Liam-McCord/PNP-Project-ENMT211/printing comparison.png

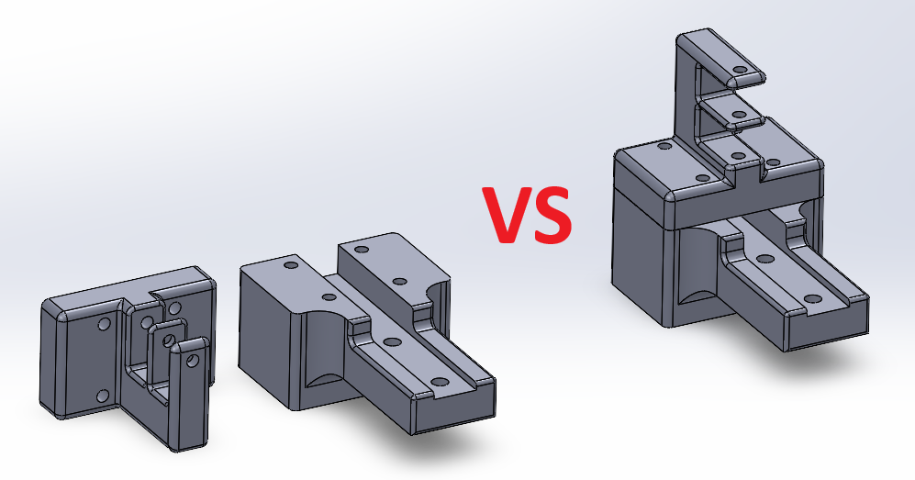
printing comparison.png
