Liam-McCord/PNP-Project-ENMT211/Report+ProjectPlanning/SketchesOfDesignIdeas/20240717_143712.jpg

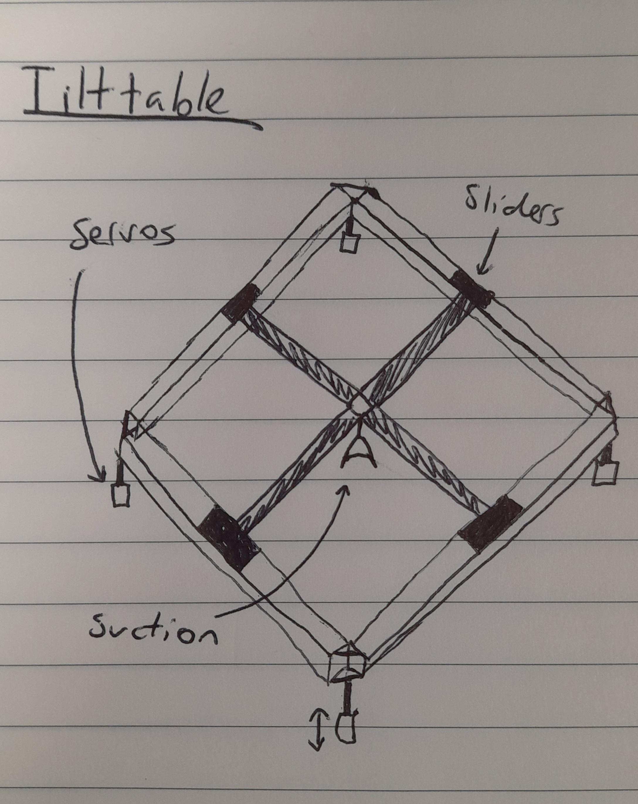
Report+ProjectPlanning/SketchesOfDesignIdeas/20240717_143712.jpg
