Liam-McCord/PNP-Project-ENMT211/MeetingNotes/19.07-meetingtopics.md

# Topics for discussion 19.07.2024

## Design Ideas

- Re-orientate bearing slides to upmost edges
- Discuss lead-screw rather than belt drive
- Discuss material selection

## Administration

- Decide on next meeting time/place
- Decide on time-line for project
- Decide when/if we are doing presentation

## Outcomes (hopefully!)

- Finalise (somewhat) initial design
- Ensure everyone is on same page/understanding
- Ensure everyone is happy with current progress/state of project
