Liam-McCord/PNP-Project-ENMT211/Report+ProjectPlanning/SketchesOfDesignIdeas/PhilipGantryDesign1.pdf

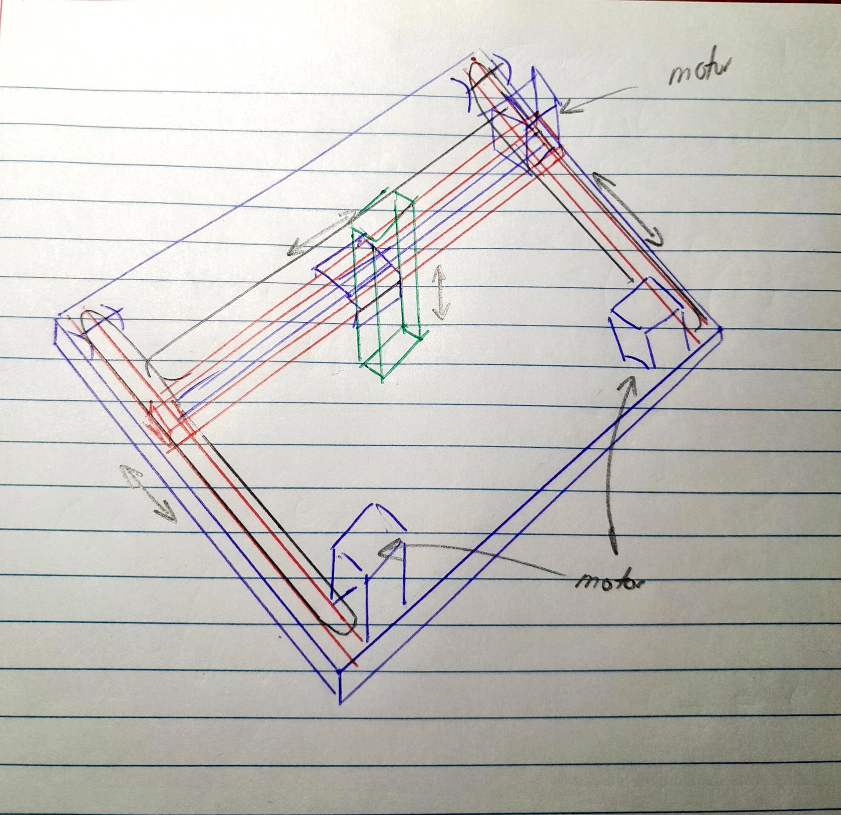
[picture p3: page 1]
