Liam-McCord/PNP-Project-ENMT211/Lab 01 Group 16 group submission/Overall Individual Contributions.pdf

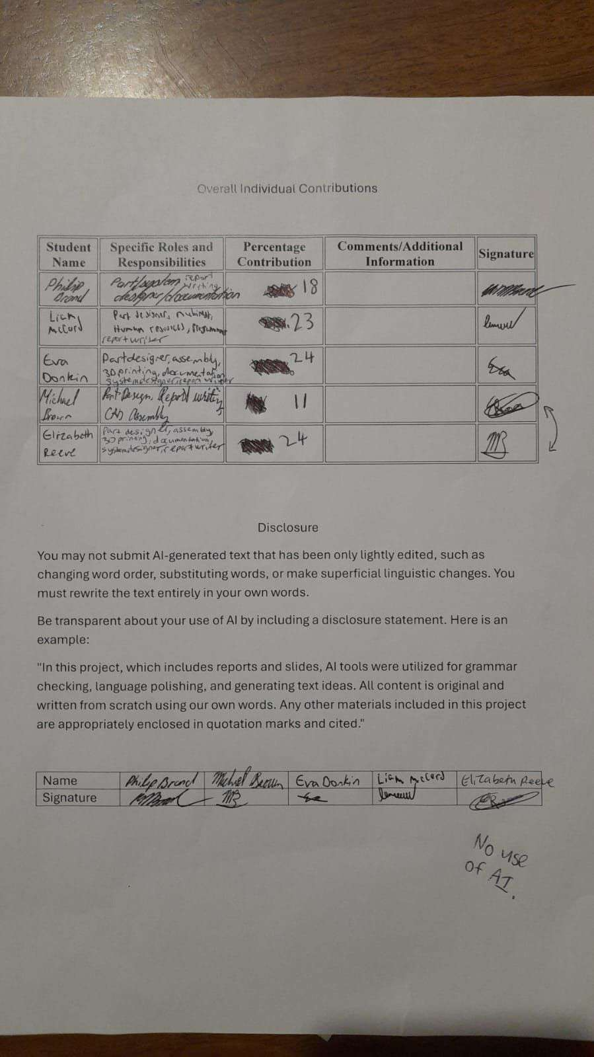
[picture p4: page 1]
