Liam-McCord/PNP-Project-ENMT211/bracket comparsion.png

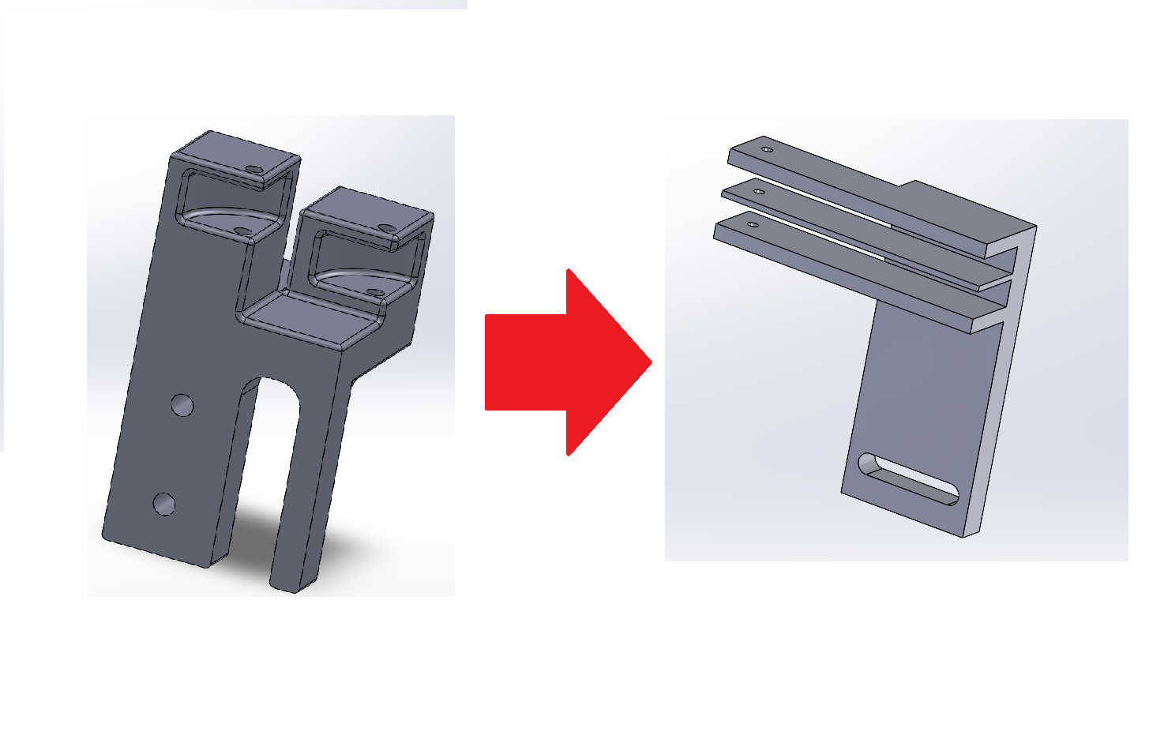
bracket comparsion.png
