Liam-McCord/PNP-Project-ENMT211/PNP.jpg

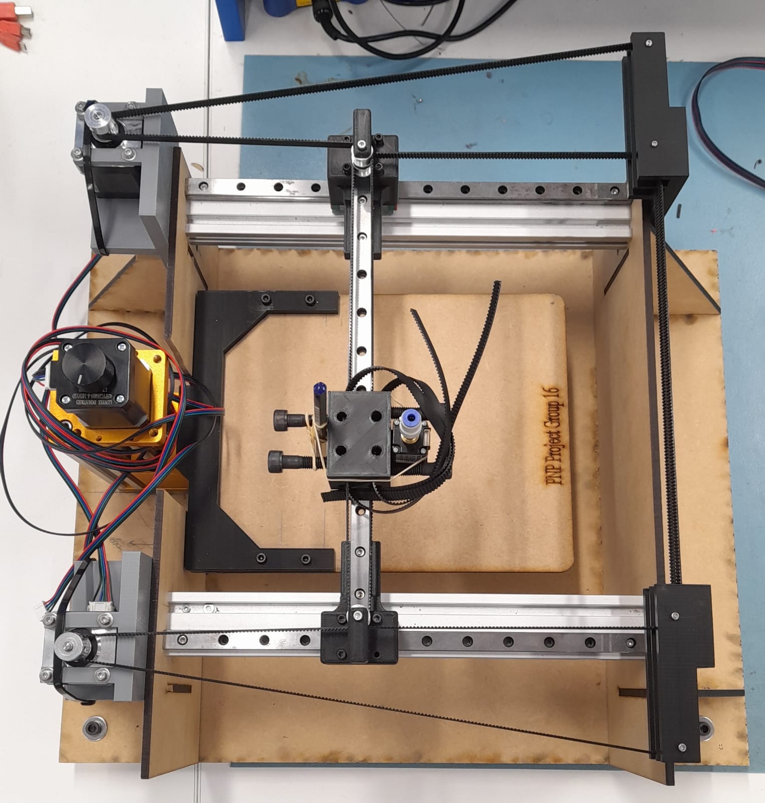
PNP.jpg
