Liam-McCord/PNP-Project-ENMT211/Report+ProjectPlanning/SketchesOfDesignIdeas/design3.png

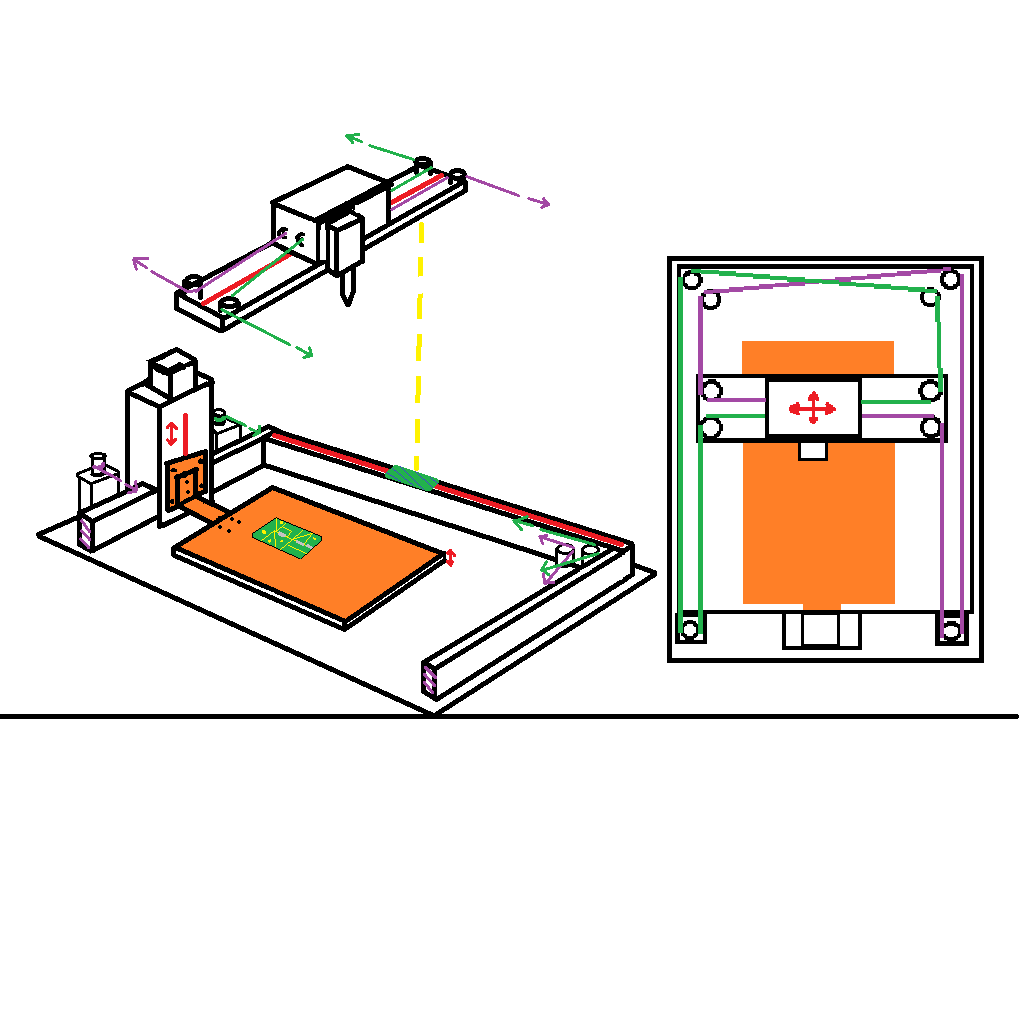
Report+ProjectPlanning/SketchesOfDesignIdeas/design3.png
