Liam-McCord/PNP-Project-ENMT211/Report+ProjectPlanning/SketchesOfDesignIdeas/IMG_0171.jpg

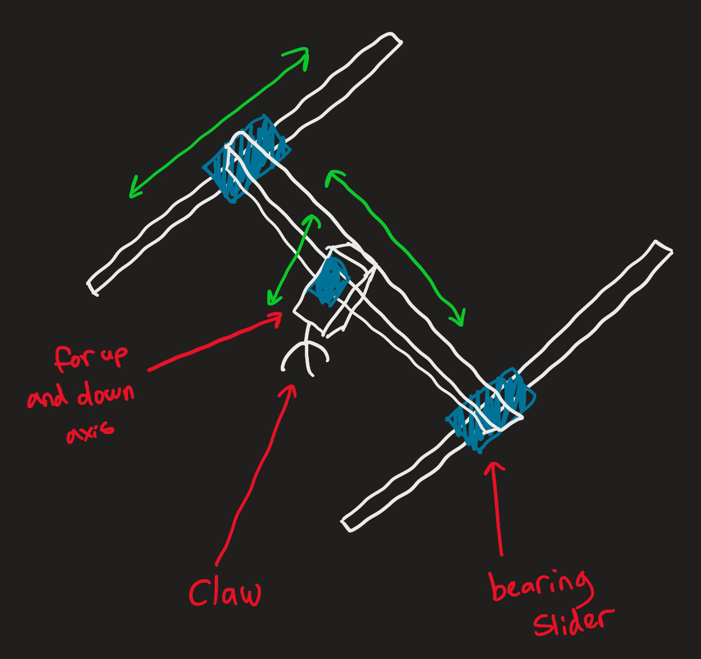
Report+ProjectPlanning/SketchesOfDesignIdeas/IMG_0171.jpg
