Liam-McCord/PNP-Project-ENMT211/Report+ProjectPlanning/SketchesOfDesignIdeas/IMG_0172.jpg

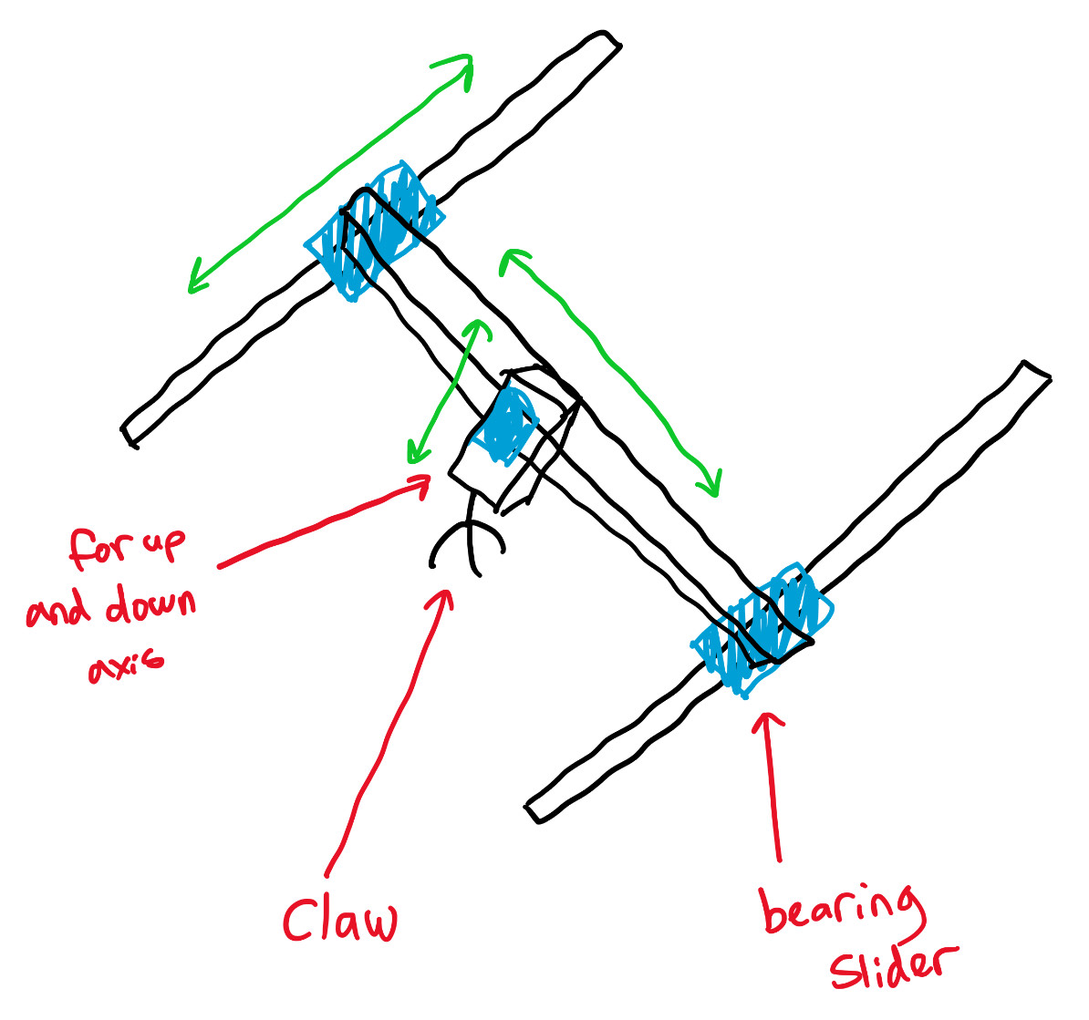
Report+ProjectPlanning/SketchesOfDesignIdeas/IMG_0172.jpg
