Liam-McCord/PNP-Project-ENMT211/Report+ProjectPlanning/SketchesOfDesignIdeas/LiamGantryDesign1.jpg

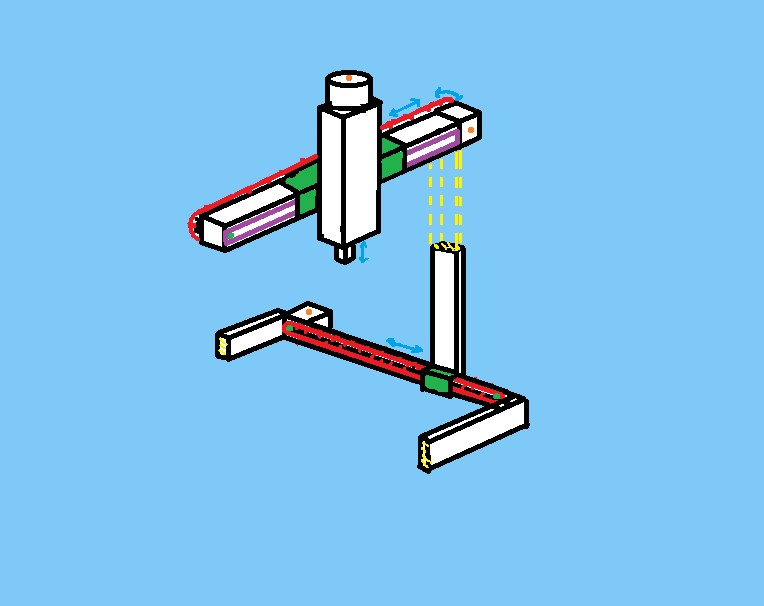
Report+ProjectPlanning/SketchesOfDesignIdeas/LiamGantryDesign1.jpg
