Liam-McCord/PNP-Project-ENMT211/Report+ProjectPlanning/SketchesOfDesignIdeas/Michael - Moving platform design.jpg

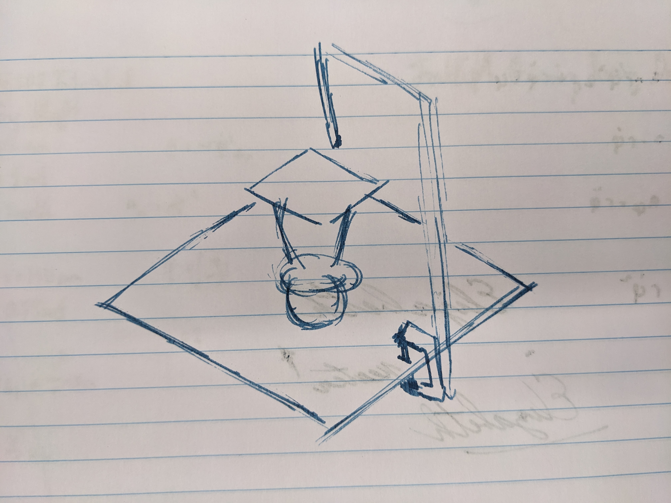
Report+ProjectPlanning/SketchesOfDesignIdeas/Michael - Moving platform design.jpg
