Liam-McCord/PNP-Project-ENMT211/Report+ProjectPlanning/SketchesOfDesignIdeas/PNPdesignupdated.png

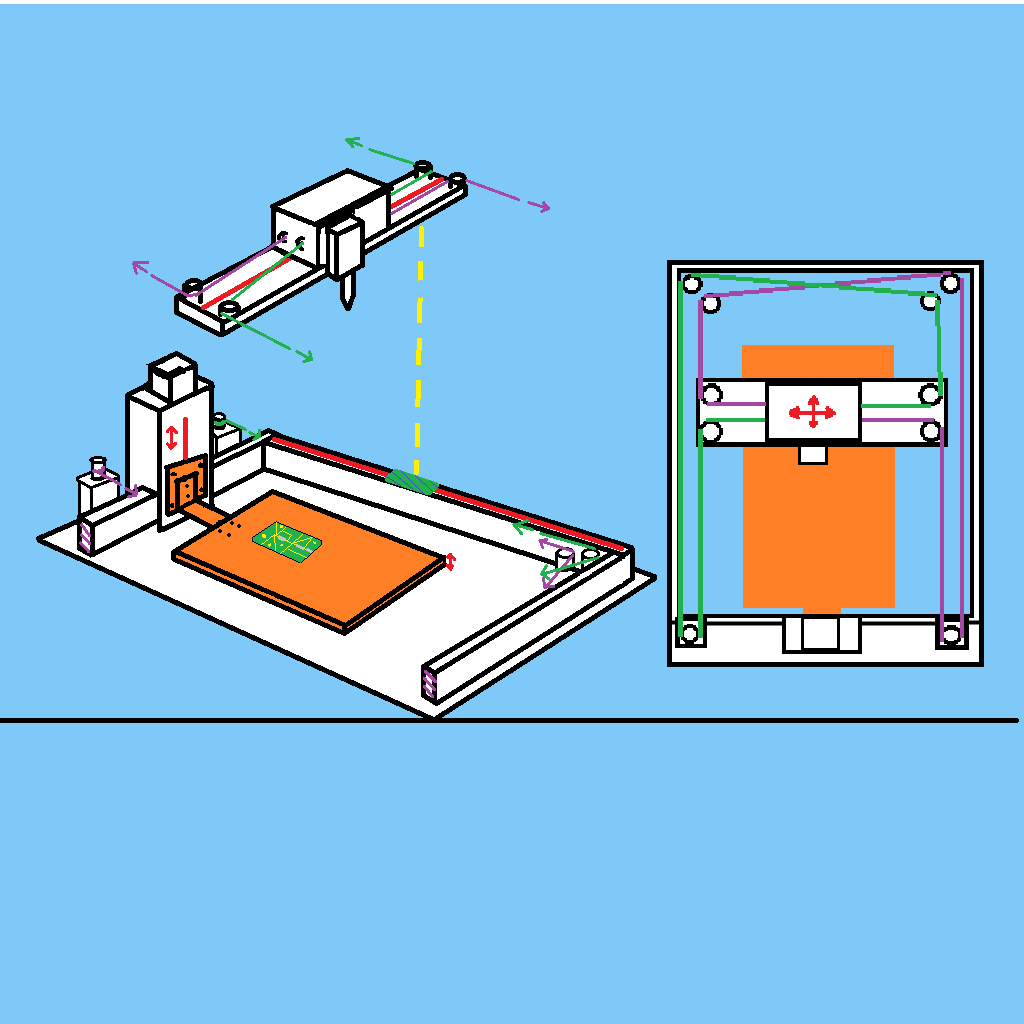
Report+ProjectPlanning/SketchesOfDesignIdeas/PNPdesignupdated.png
