Liam-McCord/PNP-Project-ENMT211/Assembly Files/Assemblies/01 - Board Assembly.SLDASM

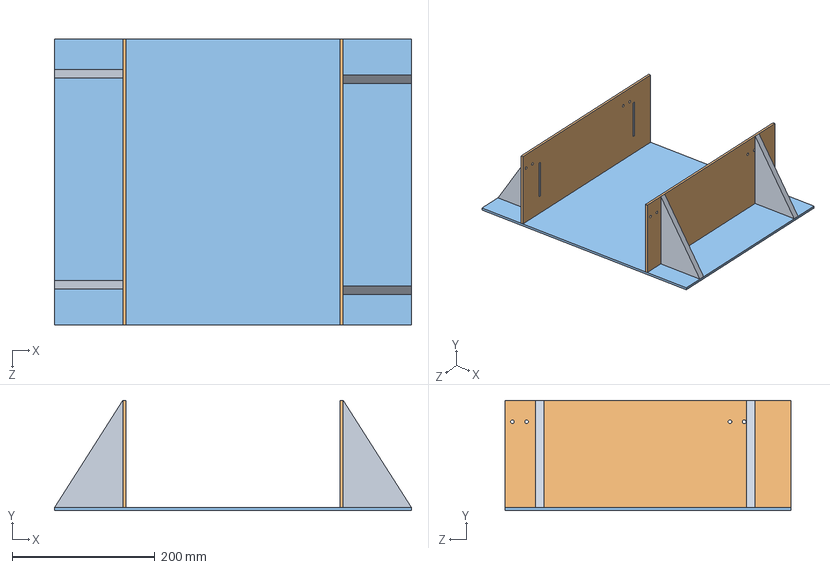
[picture p13: CAD file, 2024-08-05]
Assembly Files/Assemblies/01 - Board Assembly.SLDASM
500.0 x 154.5 x 400.1 mm
Bottom Plate
Side Walls x 2
Gussets x 4
