Liam-McCord/PNP-Project-ENMT211/Assembly Files/Assemblies/02 - Board with 2 Beams Assembly.SLDASM

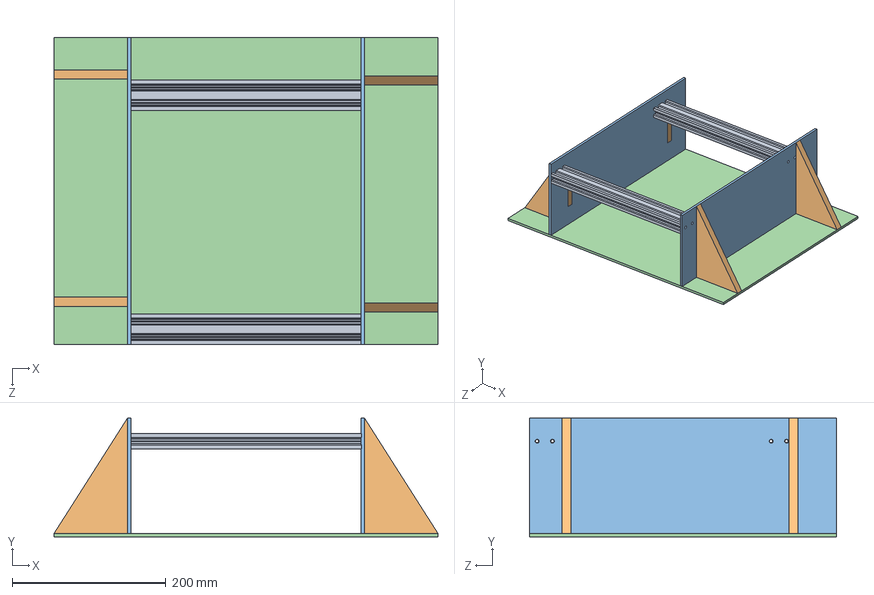
[picture p14: CAD file, 2024-08-05]
Assembly Files/Assemblies/02 - Board with 2 Beams Assembly.SLDASM
500.0 x 154.5 x 400.1 mm
Bottom Plate
Side Walls x 2
Gussets x 4
2040 Aluminim profile x 2
