Liam-McCord/PNP-Project-ENMT211/Assembly Files/Individual Parts/Slider Block/MGN12H.SLDASM

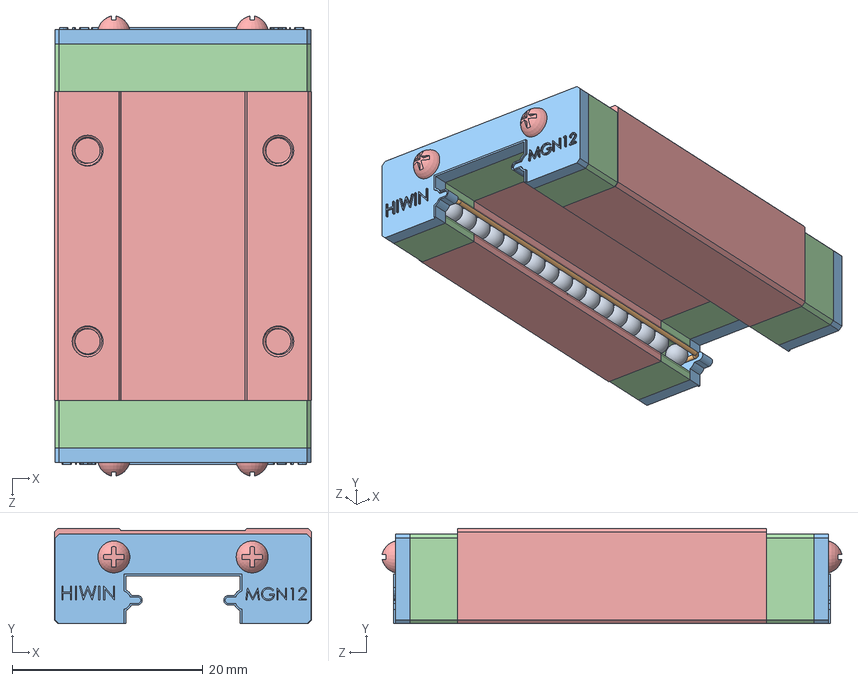
[picture p15: CAD file, 2024-08-05]
Assembly Files/Individual Parts/Slider Block/MGN12H.SLDASM
27.0 x 10.0 x 48.2 mm
MGN12H_Body
MGN12H_EndCap x 2
MGN12H_Seal x 2
MGN12H_Cage x 2
MGN12H_Ball x 34
