Liam-McCord/PNP-Project-ENMT211/Assembly Files/Assemblies/04 - Assembly with Motors.SLDASM

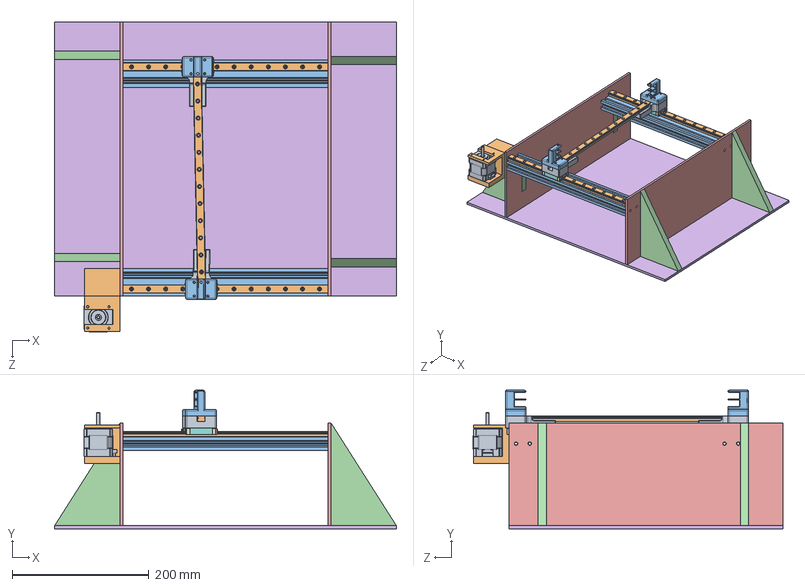
[picture p16: CAD file, 2024-08-05]
Assembly Files/Assemblies/04 - Assembly with Motors.SLDASM
500.0 x 202.5 x 452.8 mm
Bottom Plate
Side Walls x 2
Gussets x 4
2040 Aluminim profile x 2
Modified Beam 30CM x 3
Slider Attachment Bottom x 2
MGN12H_Body x 2
MGN12H_EndCap x 4
MGN12H_Seal x 4
MGN12H_Cage x 4
MGN12H_Ball x 68
Slider Attachment Top x 2
Motor Mount Long Side 1
DC Stepper Motor
