Liam-McCord/PNP-Project-ENMT211/Assembly Files/Individual Parts/Side Walls.SLDPRT

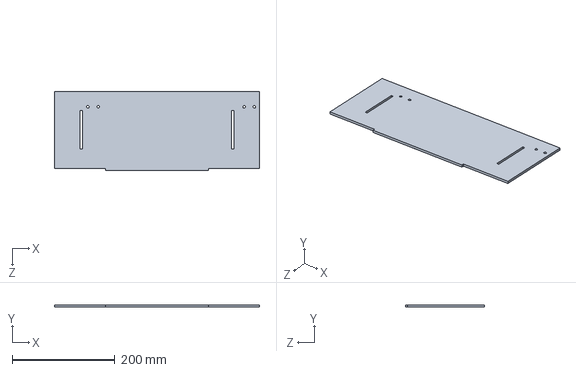
[picture p17: CAD file, 2024-08-05]
Assembly Files/Individual Parts/Side Walls.SLDPRT
400.0 x 4.50 x 154.5 mm
