Liam-McCord/PNP-Project-ENMT211/Assembly Files/Individual Parts/Slider Block/MGN12H_Seal.SLDPRT

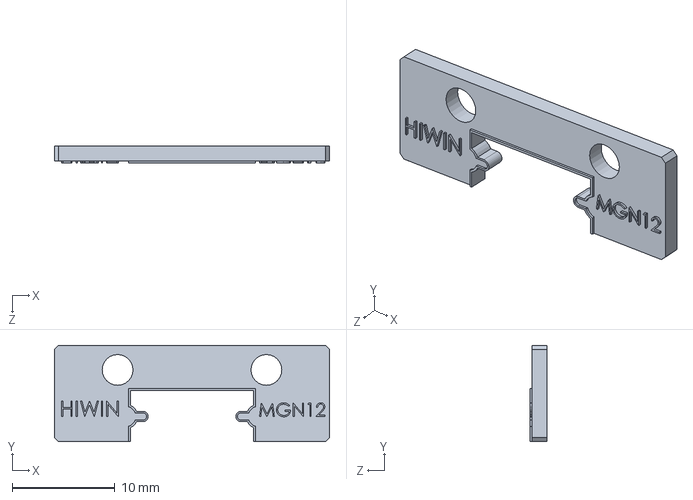
[picture p18: CAD file, 2024-08-05]
Assembly Files/Individual Parts/Slider Block/MGN12H_Seal.SLDPRT
26.8 x 9.40 x 1.70 mm
