Liam-McCord/PNP-Project-ENMT211/Lab 01 Group 16 group submission/CAD files/FDM/pulley support.SLDPRT

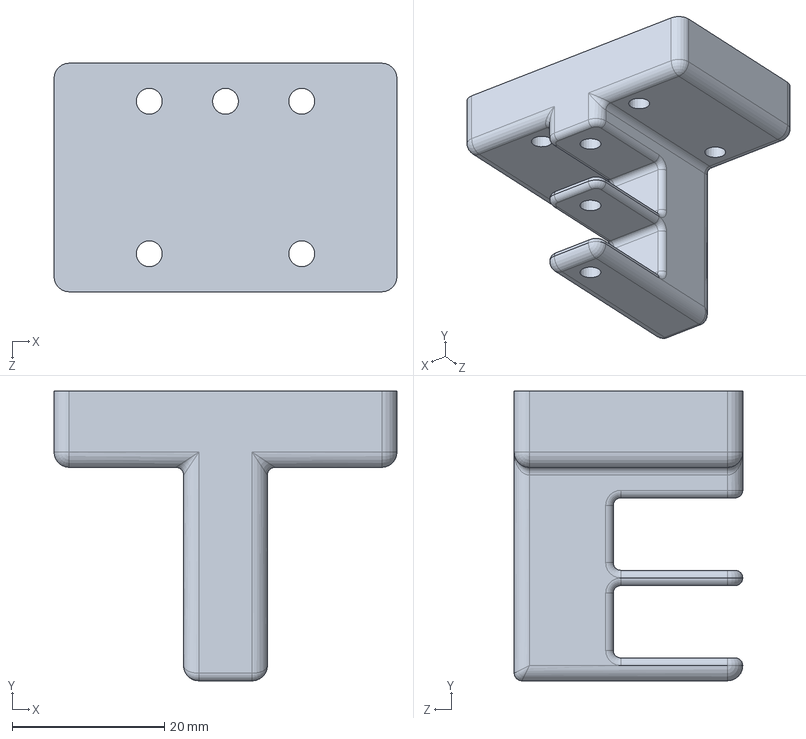
[picture p19: CAD file, 2024-08-16]
Lab 01 Group 16 group submission/CAD files/FDM/pulley support.SLDPRT
45.0 x 38.0 x 30.0 mm
