Liam-McCord/PNP-Project-ENMT211/Lab 01 Group 16 group submission/CAD files/lasercutting/baseplate-plate-to-lasercut.SLDPRT

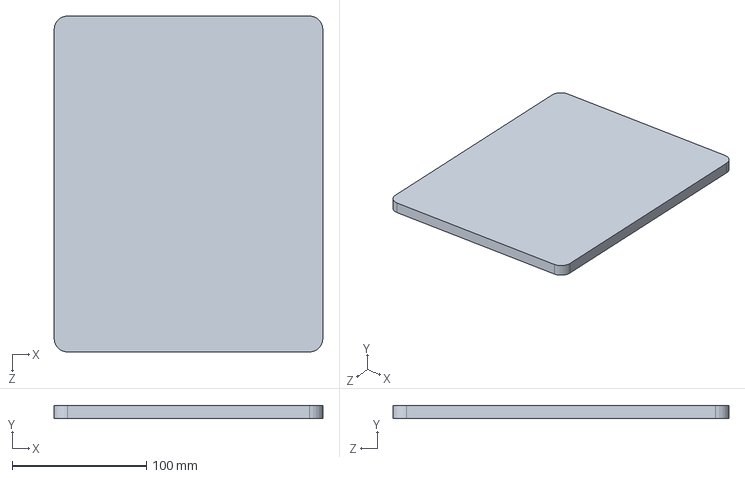
[picture p20: CAD file, 2024-08-06]
Lab 01 Group 16 group submission/CAD files/lasercutting/baseplate-plate-to-lasercut.SLDPRT
200.0 x 10.0 x 250.0 mm
