Liam-McCord/PNP-Project-ENMT211/Mounts&Brackets for Printing/bracket connecting perpendicular glides/rail mount/part1-final.STL

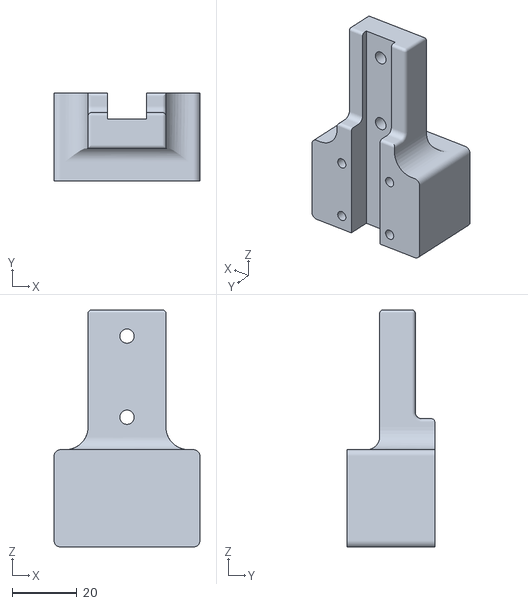
[picture p21: CAD file, 2024-08-06]
Mounts&Brackets for Printing/bracket connecting perpendicular glides/rail mount/part1-final.STL
45.0 x 27.0 x 73.1
