Liam-McCord/PNP-Project-ENMT211/Mounts&Brackets for Printing/motor mount/Motor Mount.STL

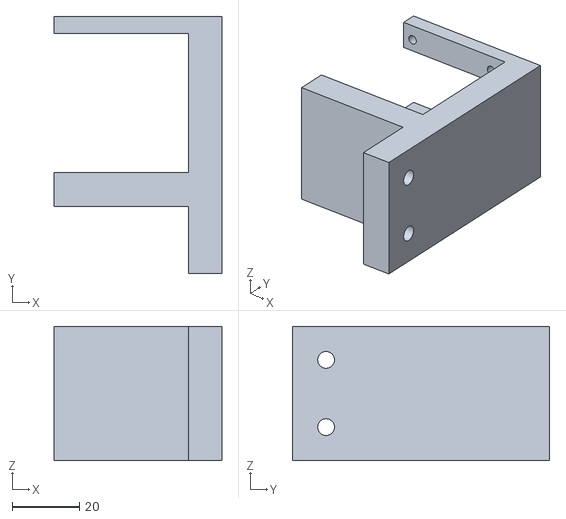
[picture p22: CAD file, 2024-08-05]
Mounts&Brackets for Printing/motor mount/Motor Mount.STL
50.0 x 76.5 x 40.0
