Liam-McCord/PNP-Project-ENMT211/Mounts&Brackets for Printing/Moving Platform Mount.STL

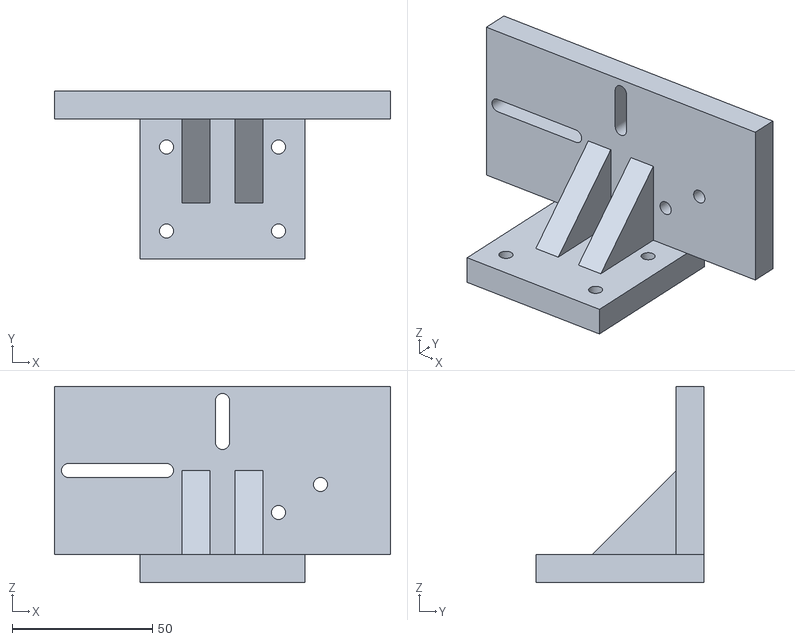
[picture p23: CAD file, 2024-07-30]
Mounts&Brackets for Printing/Moving Platform Mount.STL
120.0 x 60.0 x 70.0
