Liam-McCord/PNP-Project-ENMT211/partstolasercut/movingpart.SLDPRT

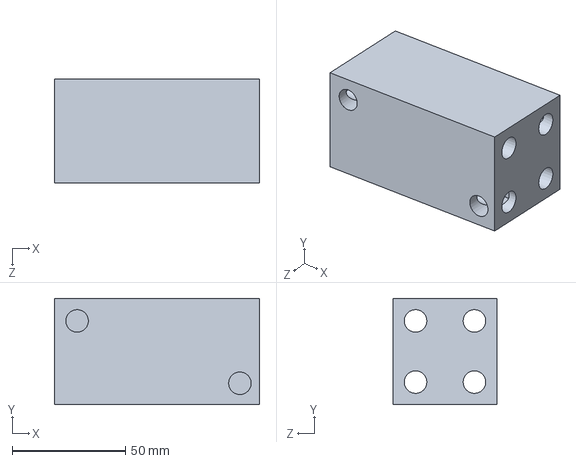
[picture p24: CAD file, 2024-07-23]
partstolasercut/movingpart.SLDPRT
90.6 x 47.1 x 46.0 mm
