Liam-McCord/PNP-Project-ENMT211/Pieces for Cutting/gussets.DXF

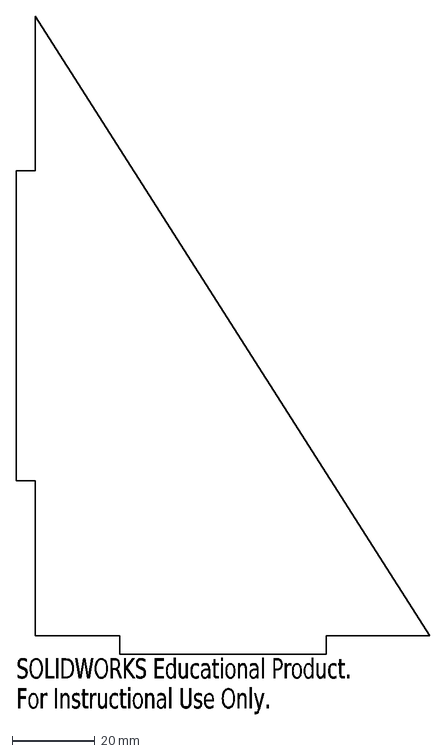
[picture p25: CAD file, 2024-07-29]
Pieces for Cutting/gussets.DXF
SOLIDWORKS Educational Product.
For Instructional Use Only.
