Liam-McCord/PNP-Project-ENMT211/Assembly Files/Individual Parts/Bottom Plate.SLDPRT

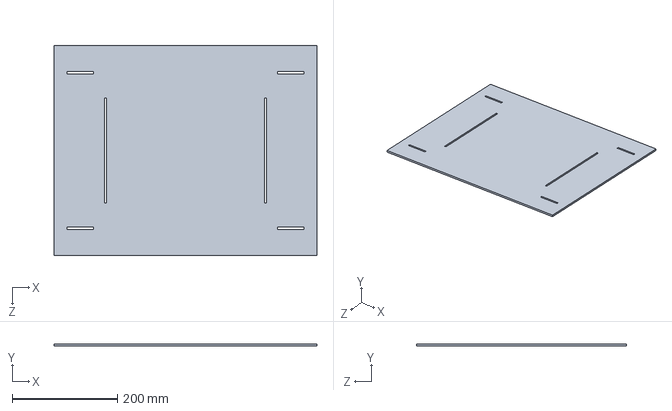
[picture p26: CAD file, 2024-08-05]
Assembly Files/Individual Parts/Bottom Plate.SLDPRT
500.0 x 4.50 x 400.0 mm
