Liam-McCord/PNP-Project-ENMT211/Assembly Files/Individual Parts/Slider Block/MGN12H_Ball.SLDPRT

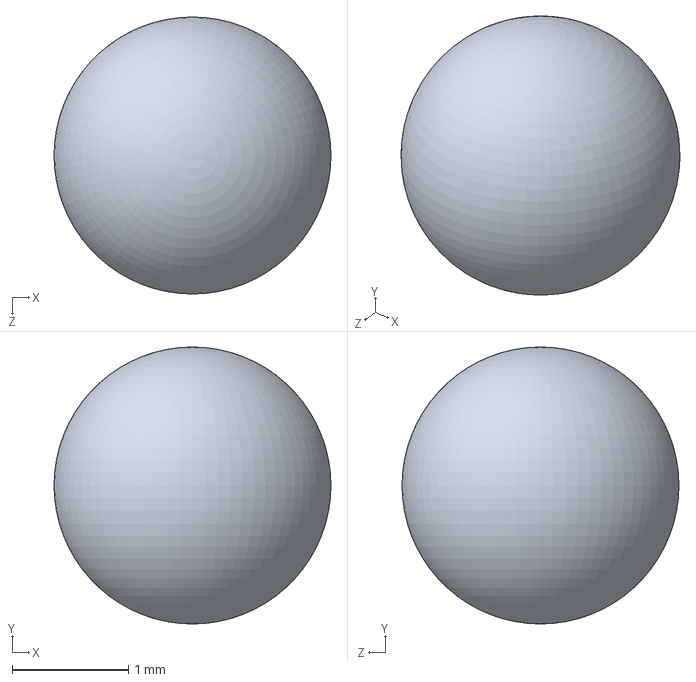
[picture p27: CAD file, 2024-08-05]
Assembly Files/Individual Parts/Slider Block/MGN12H_Ball.SLDPRT
2.38 x 2.38 x 2.38 mm
