Liam-McCord/PNP-Project-ENMT211/Lab 01 Group 16 group submission/CAD files/lasercutting/gussets.SLDPRT

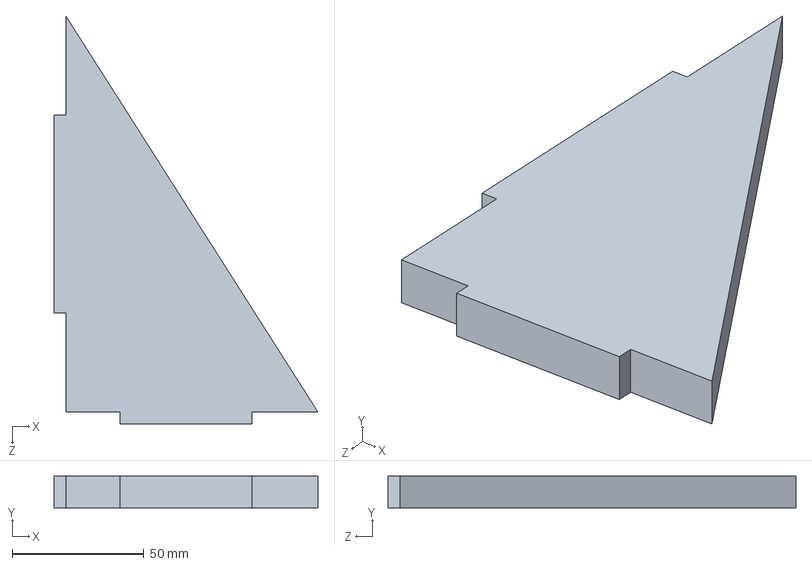
[picture p28: CAD file, 2024-07-27]
Lab 01 Group 16 group submission/CAD files/lasercutting/gussets.SLDPRT
100.0 x 12.0 x 154.5 mm
