Liam-McCord/PNP-Project-ENMT211/Mountblock updated.STL

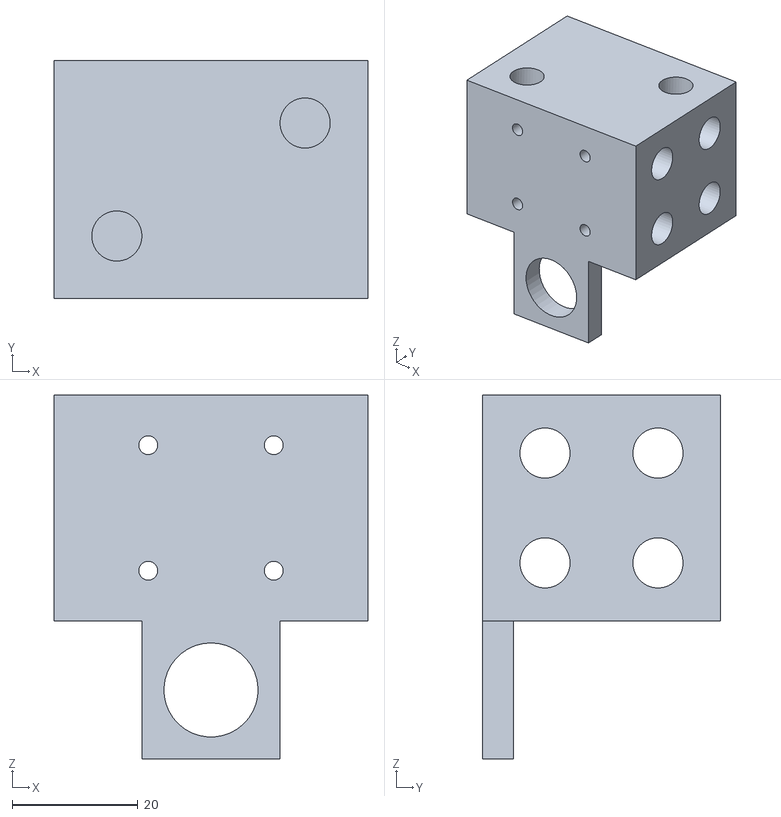
[picture p29: CAD file, 2024-08-06]
Mountblock updated.STL
50.0 x 38.0 x 58.0
