Liam-McCord/PNP-Project-ENMT211/Pieces for Cutting/side_walls.DXF

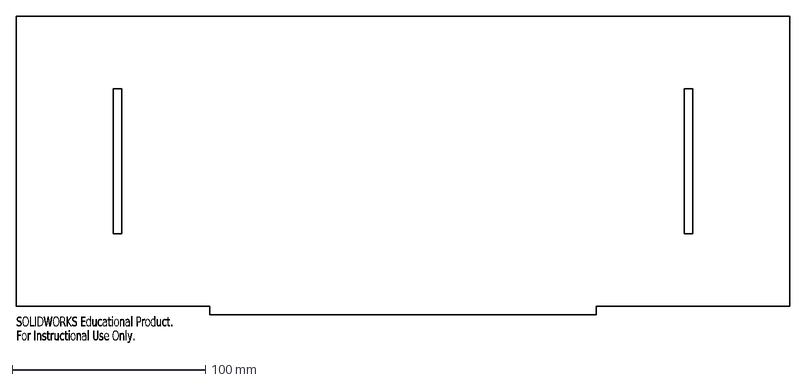
[picture p30: CAD file, 2024-07-29]
Pieces for Cutting/side_walls.DXF
SOLIDWORKS Educational Product.
For Instructional Use Only.
