Liam-McCord/PNP-Project-ENMT211/Assembly Files/Individual Parts/Slider Attachment Bottom.SLDPRT

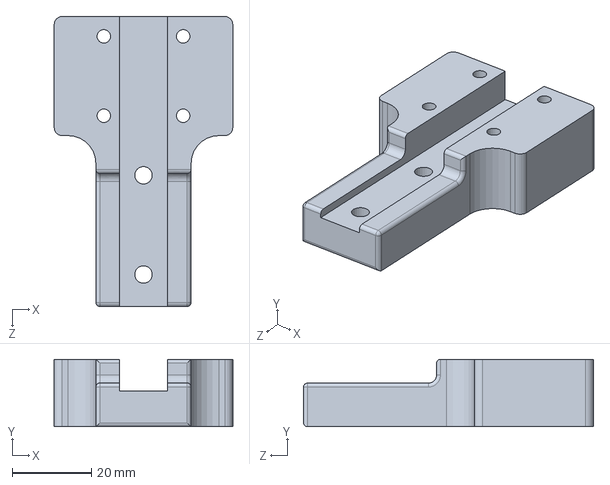
[picture p31: CAD file, 2024-08-05]
Assembly Files/Individual Parts/Slider Attachment Bottom.SLDPRT
45.0 x 17.0 x 73.1 mm
