Liam-McCord/PNP-Project-ENMT211/Lab 01 Group 16 group submission/CAD files/FDM/pulley mount 3.SLDPRT

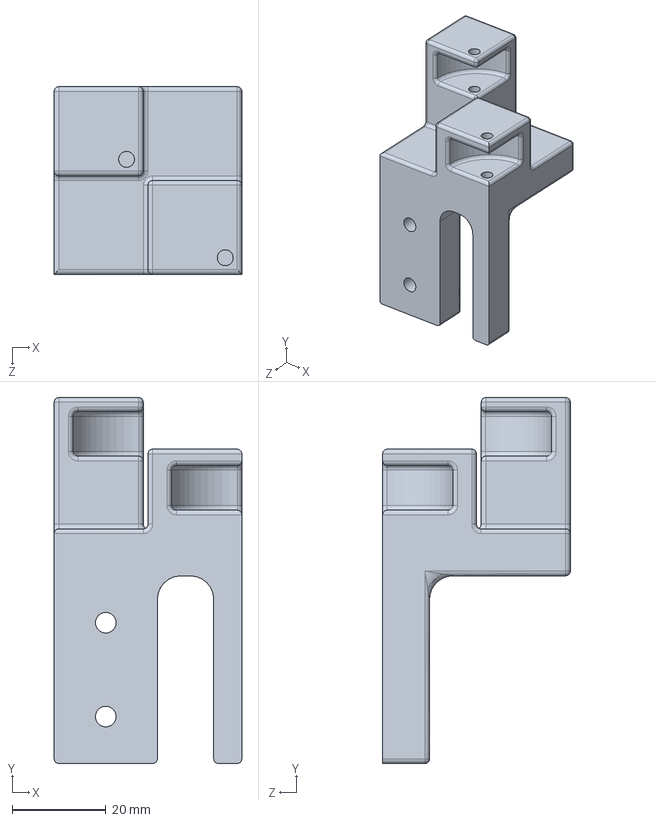
[picture p32: CAD file, 2024-08-16]
Lab 01 Group 16 group submission/CAD files/FDM/pulley mount 3.SLDPRT
40.0 x 78.0 x 40.0 mm
