Liam-McCord/PNP-Project-ENMT211/Lab 01 Group 16 group submission/CAD files/lasercutting/side_walls.SLDPRT

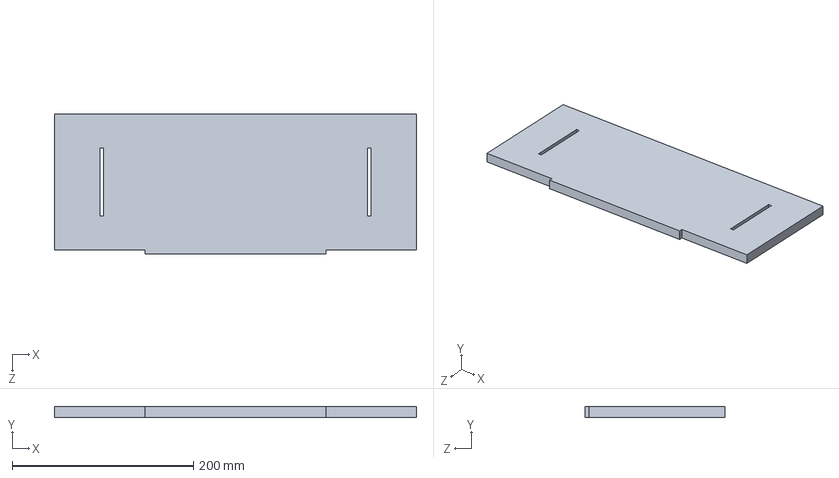
[picture p33: CAD file, 2024-07-27]
Lab 01 Group 16 group submission/CAD files/lasercutting/side_walls.SLDPRT
400.0 x 12.0 x 154.5 mm
