Liam-McCord/PNP-Project-ENMT211/Motor Mount Updated.STL

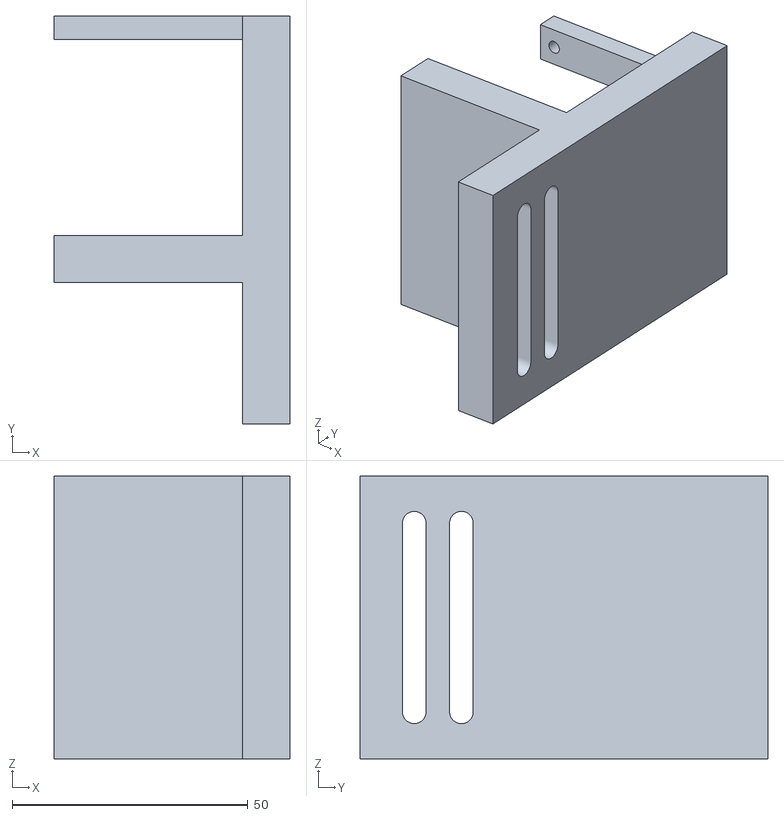
[picture p34: CAD file, 2024-08-06]
Motor Mount Updated.STL
50.0 x 86.5 x 60.0
