Liam-McCord/PNP-Project-ENMT211/Pieces for Cutting/bottomplatePNP.DXF

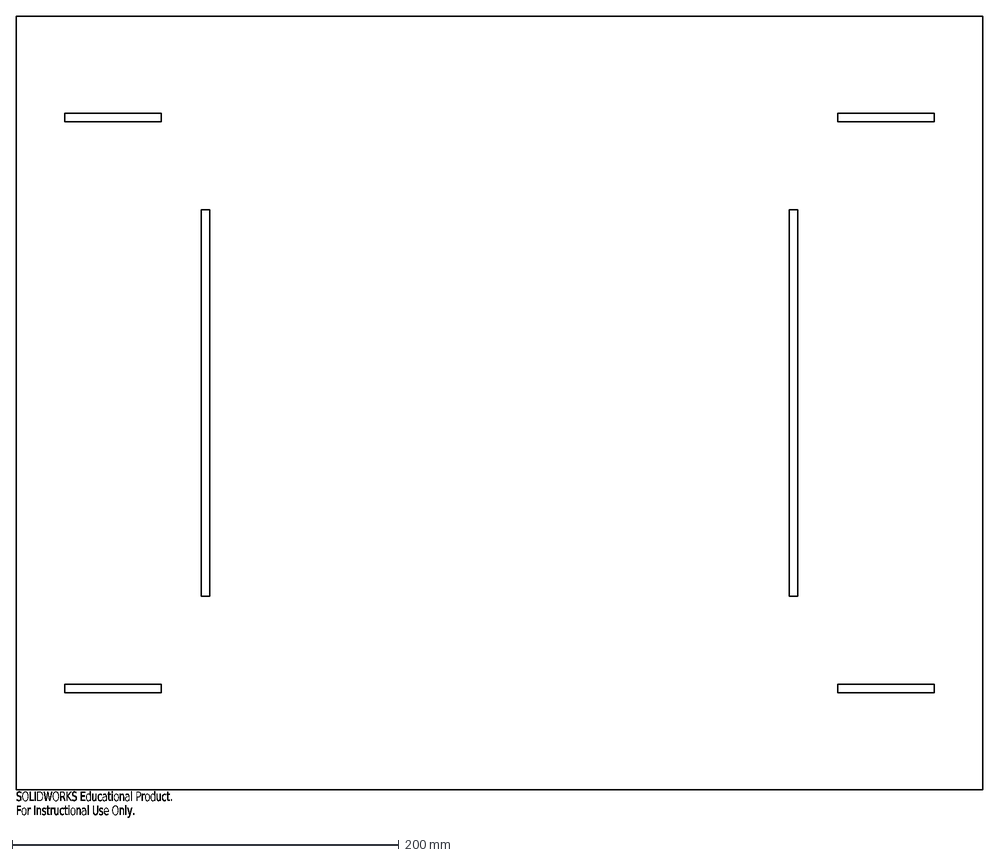
[picture p35: CAD file, 2024-07-29]
Pieces for Cutting/bottomplatePNP.DXF
SOLIDWORKS Educational Product.
For Instructional Use Only.
