Liam-McCord/PNP-Project-ENMT211/Assembly Files/Individual Parts/Modified Beam 30CM.SLDPRT

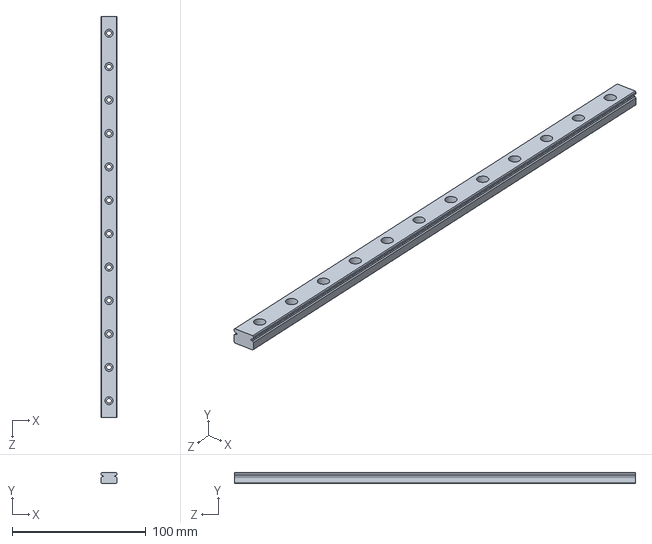
[picture p36: CAD file, 2024-08-05]
Assembly Files/Individual Parts/Modified Beam 30CM.SLDPRT
12.0 x 8.00 x 300.0 mm
