Liam-McCord/PNP-Project-ENMT211/Assembly Files/Individual Parts/Slider Block/MGN12H_Cage.SLDPRT

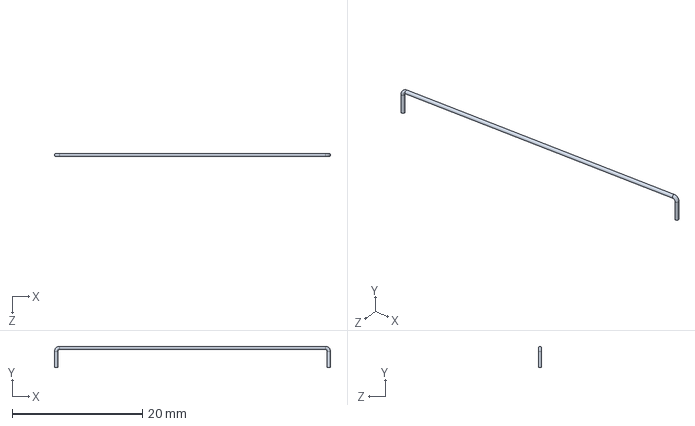
[picture p37: CAD file, 2024-08-05]
Assembly Files/Individual Parts/Slider Block/MGN12H_Cage.SLDPRT
42.4 x 3.25 x 0.5 mm
