Liam-McCord/PNP-Project-ENMT211/Lab 01 Group 16 group submission/CAD files/FDM/baseplate  v2.SLDPRT

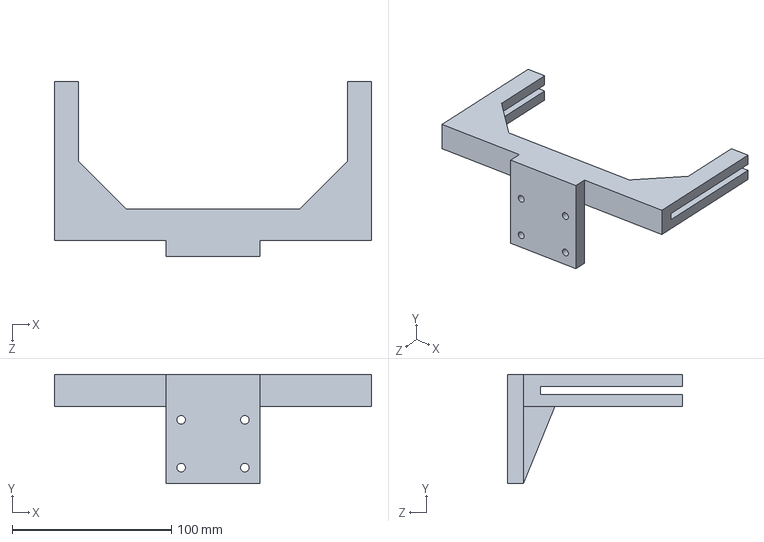
[picture p38: CAD file, 2024-08-06]
Lab 01 Group 16 group submission/CAD files/FDM/baseplate v2.SLDPRT
199.0 x 68.5 x 109.8 mm
