Liam-McCord/PNP-Project-ENMT211/Lab 01 Group 16 group submission/CAD files/lasercutting/bottomplatePNP.SLDPRT

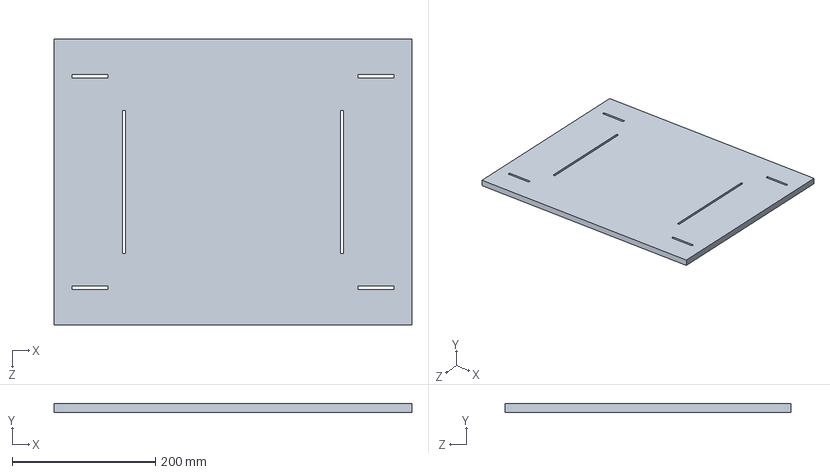
[picture p39: CAD file, 2024-07-27]
Lab 01 Group 16 group submission/CAD files/lasercutting/bottomplatePNP.SLDPRT
500.0 x 12.0 x 400.0 mm
