Liam-McCord/PNP-Project-ENMT211/Assembly Files/Individual Parts/DC Stepper Motor.SLDPRT

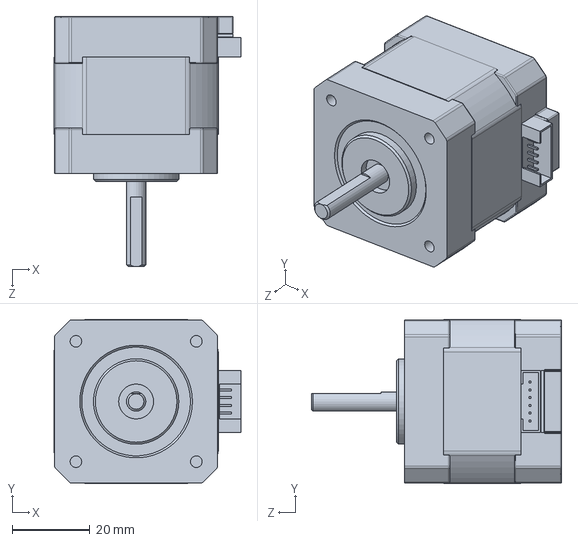
[picture p40: CAD file, 2024-08-05]
Assembly Files/Individual Parts/DC Stepper Motor.SLDPRT
48.2 x 42.3 x 64.5 mm
