Liam-McCord/PNP-Project-ENMT211/Assembly Files/Individual Parts/Slider Block/MGN12H_Body.SLDPRT

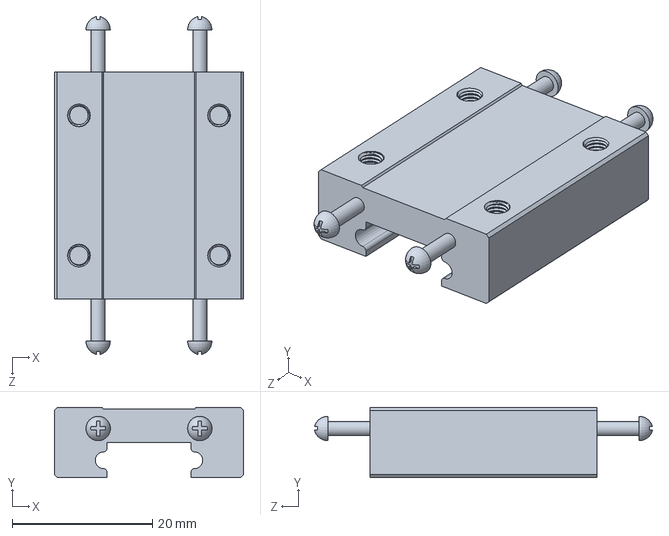
[picture p41: CAD file, 2024-08-05]
Assembly Files/Individual Parts/Slider Block/MGN12H_Body.SLDPRT
27.0 x 10.0 x 48.2 mm
