Liam-McCord/PNP-Project-ENMT211/Assembly Files/Individual Parts/Motor Mount.SLDPRT

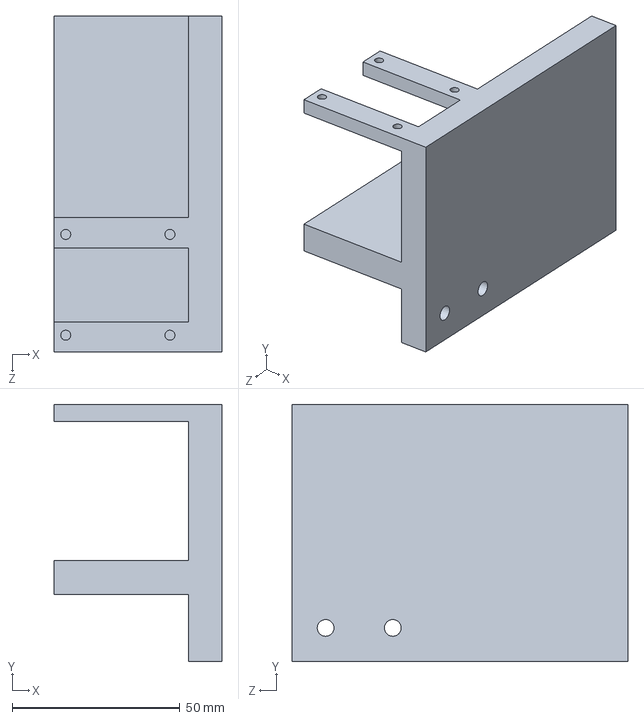
[picture p42: CAD file, 2024-08-05]
Assembly Files/Individual Parts/Motor Mount.SLDPRT
50.0 x 76.5 x 100.0 mm
