Liam-McCord/PNP-Project-ENMT211/Assembly Files/Individual Parts/Slider Block/MGN12H_EndCap.SLDPRT

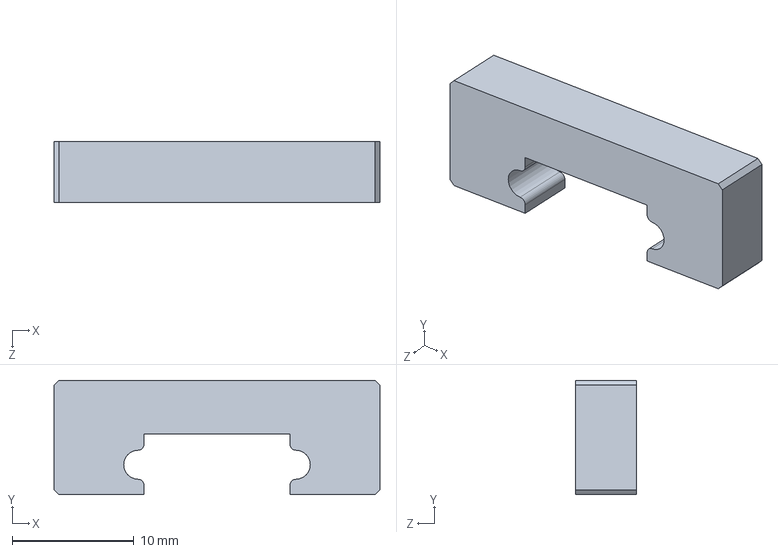
[picture p43: CAD file, 2024-08-05]
Assembly Files/Individual Parts/Slider Block/MGN12H_EndCap.SLDPRT
26.8 x 9.40 x 5.00 mm
