Liam-McCord/PNP-Project-ENMT211/Assembly Files/Individual Parts/Gussets.SLDPRT

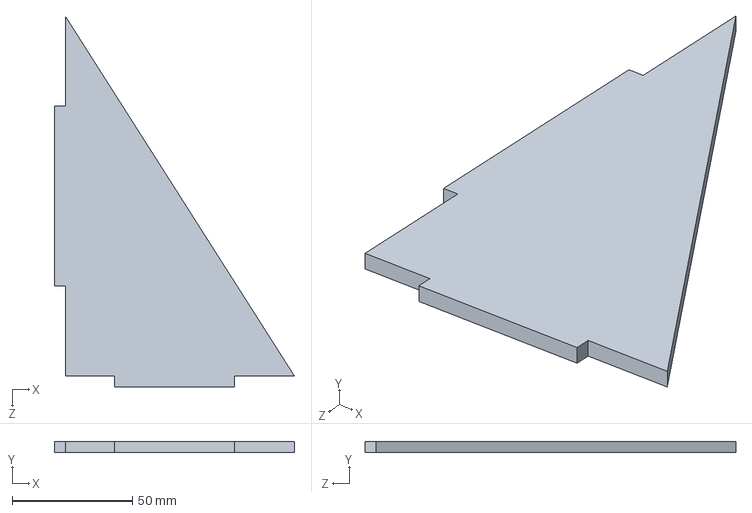
[picture p44: CAD file, 2024-08-05]
Assembly Files/Individual Parts/Gussets.SLDPRT
100.0 x 4.50 x 154.5 mm
