Liam-McCord/PNP-Project-ENMT211/Lab 01 Group 16 group submission/CAD files/FDM/motor mount with clearance pulley.SLDPRT

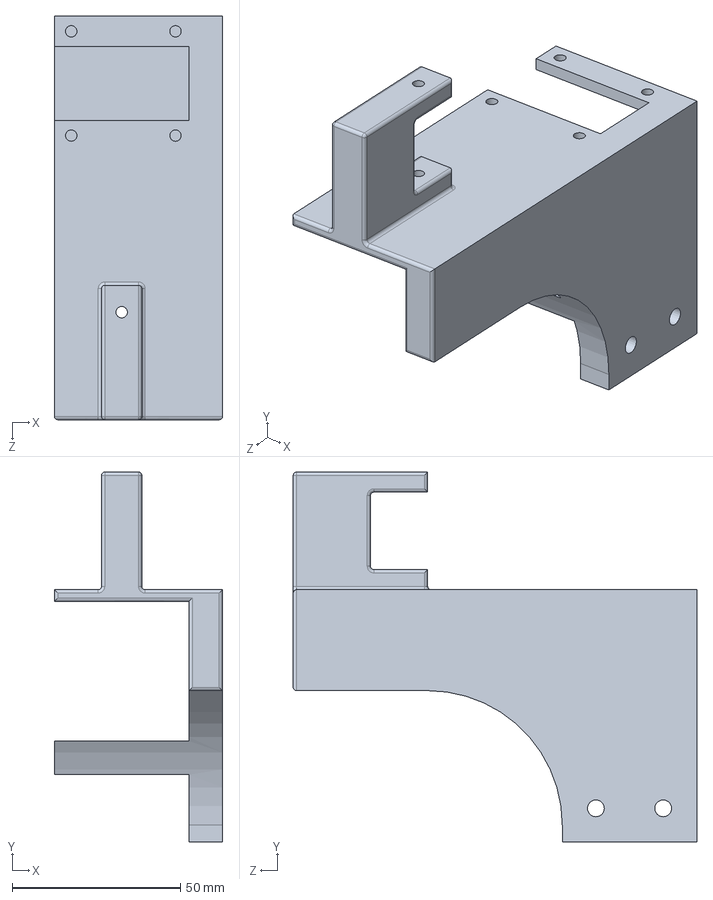
[picture p45: CAD file, 2024-08-05]
Lab 01 Group 16 group submission/CAD files/FDM/motor mount with clearance pulley.SLDPRT
50.0 x 110.0 x 120.0 mm
