Liam-McCord/PNP-Project-ENMT211/Lab 01 Group 16 group submission/CAD files/FDM/pulley mount 1.SLDPRT

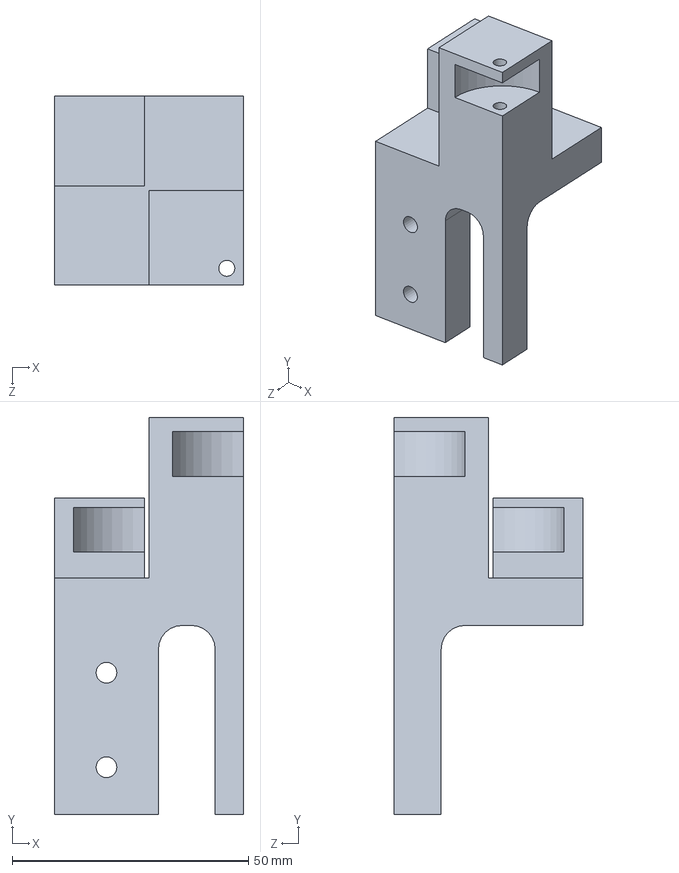
[picture p46: CAD file, 2024-08-05]
Lab 01 Group 16 group submission/CAD files/FDM/pulley mount 1.SLDPRT
40.0 x 84.0 x 40.0 mm
