Liam-McCord/PNP-Project-ENMT211/Assembly Files/Individual Parts/2040 Aluminim profile.SLDPRT

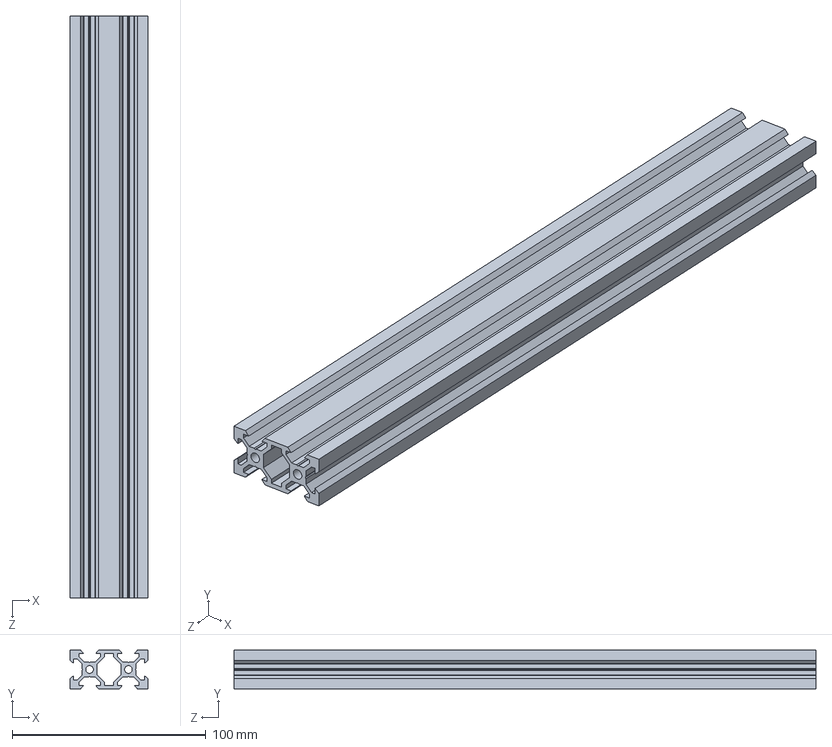
[picture p47: CAD file, 2024-08-05]
Assembly Files/Individual Parts/2040 Aluminim profile.SLDPRT
40.0 x 20.0 x 300.0 mm
