Liam-McCord/PNP-Project-ENMT211/Lab 01 Group 16 group submission/CAD files/FDM/pulley mount 2.SLDPRT

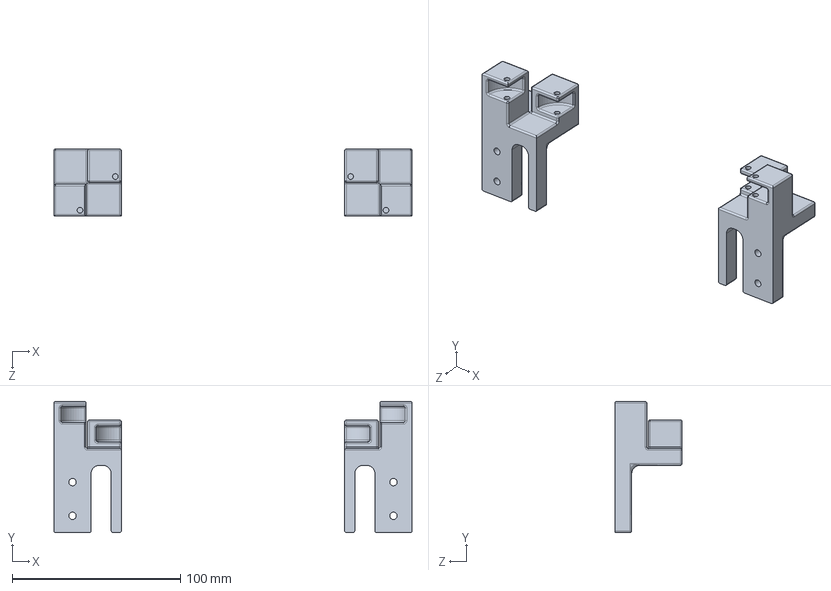
[picture p48: CAD file, 2024-08-05]
Lab 01 Group 16 group submission/CAD files/FDM/pulley mount 2.SLDPRT
212.7 x 78.0 x 40.0 mm
