Liam-McCord/PNP-Project-ENMT211/Assembly Files/Individual Parts/Motor Mount Long Side 1.SLDPRT

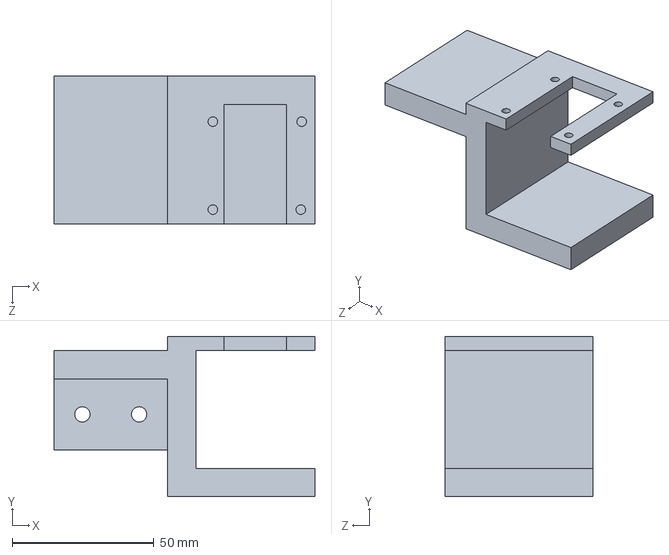
[picture p49: CAD file, 2024-08-05]
Assembly Files/Individual Parts/Motor Mount Long Side 1.SLDPRT
92.0 x 56.5 x 52.0 mm
