Liam-McCord/PNP-Project-ENMT211/Lab 01 Group 16 group submission/CAD files/FDM/clerance pulley.SLDPRT

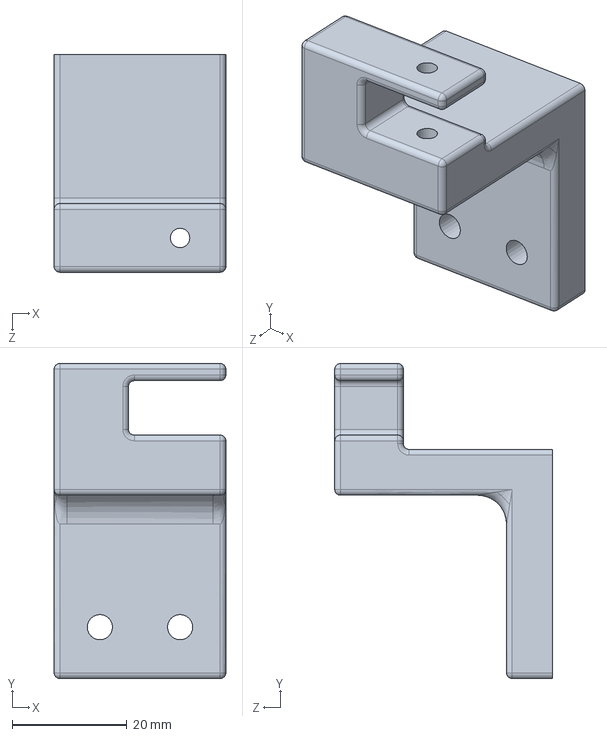
[picture p50: CAD file, 2024-08-01]
Lab 01 Group 16 group submission/CAD files/FDM/clerance pulley.SLDPRT
30.0 x 55.0 x 38.0 mm
