Liam-McCord/PNP-Project-ENMT211/comparison of pulley printingSLDASM.SLDASM

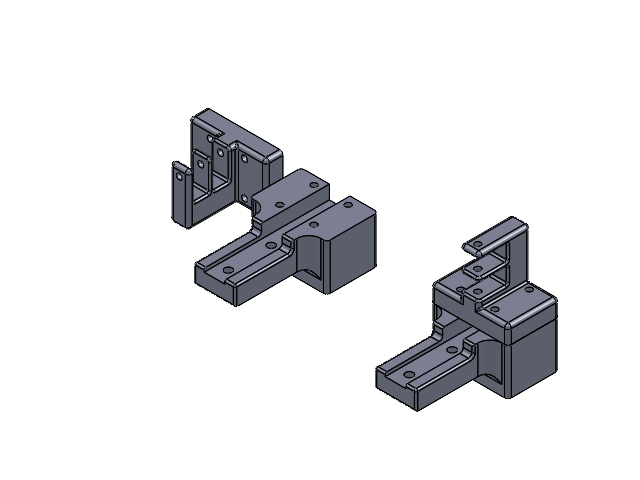
[picture p51: CAD file, 2024-08-16]
comparison of pulley printingSLDASM.SLDASM
part1-final x 2
