Liam-McCord/PNP-Project-ENMT211/Mounts&Brackets for Printing/bracket connecting perpendicular glides/xybracket.SLDASM

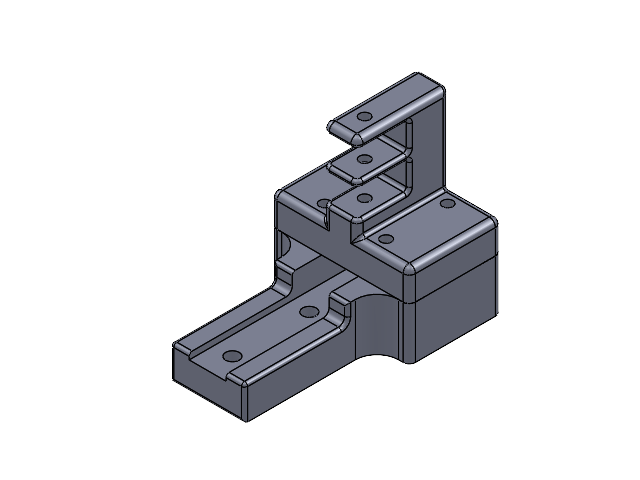
[picture p52: CAD file, 2024-07-27]
Mounts&Brackets for Printing/bracket connecting perpendicular glides/xybracket.SLDASM
