Liam-McCord/PNP-Project-ENMT211/(list of files, cad)

Other CAD files:
Mounts&Brackets for Printing/bracket connecting perpendicular glides/pulley mount/Part2.STL
Lab 01 Group 16 group submission/CAD files/FDM/perpendicular axis support.SLDPRT
Mounts&Brackets for Printing/motor mount/mountblock.STL
Assembly Files/Assemblies/MGN12H_Ball.STEP.SLDPRT
Lab 01 Group 16 group submission/CAD files/FDM/mount block v2.SLDPRT
Assembly Files/Assemblies/MGN12H_EndCap.STEP.SLDPRT
Lab 01 Group 16 group submission/CAD files/FDM/motor mount v2.SLDPRT
Assembly Files/Assemblies/MGN12H_Cage.STEP.SLDPRT
Assembly Files/Assemblies/MGN12H_Seal.STEP.SLDPRT
Assembly Files/Individual Parts/Slider Attachment Top.SLDPRT
Assembly Files/Assemblies/xy_joint_right_lower_MGN12.step.STEP.SLDPRT
Assembly Files/Assemblies/MGNR12R350HM.STEP.SLDPRT
Assembly Files/Assemblies/BType_TNut_6_M5.STEP.SLDPRT
Assembly Files/Assemblies/xy_joint_left_upper_MGN12.step.STEP.SLDPRT
Assembly Files/Assemblies/MGN12H_Body.STEP.SLDPRT
Assembly Files/Assemblies/Voron_XAxis_LW_300.STEP.SLDPRT
Assembly Files/Assemblies/xy_joint_left_lower_MGN12.step.STEP.SLDPRT
Assembly Files/Assemblies/xy_joint_right_upper_MGN12.step.STEP.SLDPRT
Assembly Files/Assemblies/Screw_DIN_912_M3x8F_A2.STEP.SLDPRT
Assembly Files/Assemblies/Screw_ISO_7380-1_M5x10_A2.STEP.SLDPRT
Assembly Files/Assemblies/Screw_ISO_7380-1_M5x30_A2.STEP.SLDPRT
Lab 01 Group 16 group submission/CAD files/FDM/baseplate v1.SLDPRT
Lab 01 Group 16 group submission/CAD files/FDM/motor mount v1.SLDPRT
Lab 01 Group 16 group submission/CAD files/FDM/mount block v1.SLDPRT
Mounts&Brackets for Printing/bracket connecting perpendicular glides/pulley mount/Part2.SLDDRW
Mounts&Brackets for Printing/bracket connecting perpendicular glides/rail mount/Part1.SLDDRW
Old part files/partstolasercut/bottomplatePNP.SLDPRT
Old part files/partstolasercut/gussets.SLDPRT
Old part files/partstolasercut/side_walls.SLDPRT
Z-Screw-Baseplate-Connector/baseplate-bracket.STL
Z-Screw-Baseplate-Connector/baseplate-plate-to-lasercut.DXF
partstolasercut/bottomplatePNP.SLDPRT
partstolasercut/gussets.SLDPRT
partstolasercut/side_walls.SLDPRT
