Liam-McCord/PNP-Project-ENMT211/Mounts&Brackets for Printing/bracket connecting perpendicular glides/pulley mount/Part2.pdf

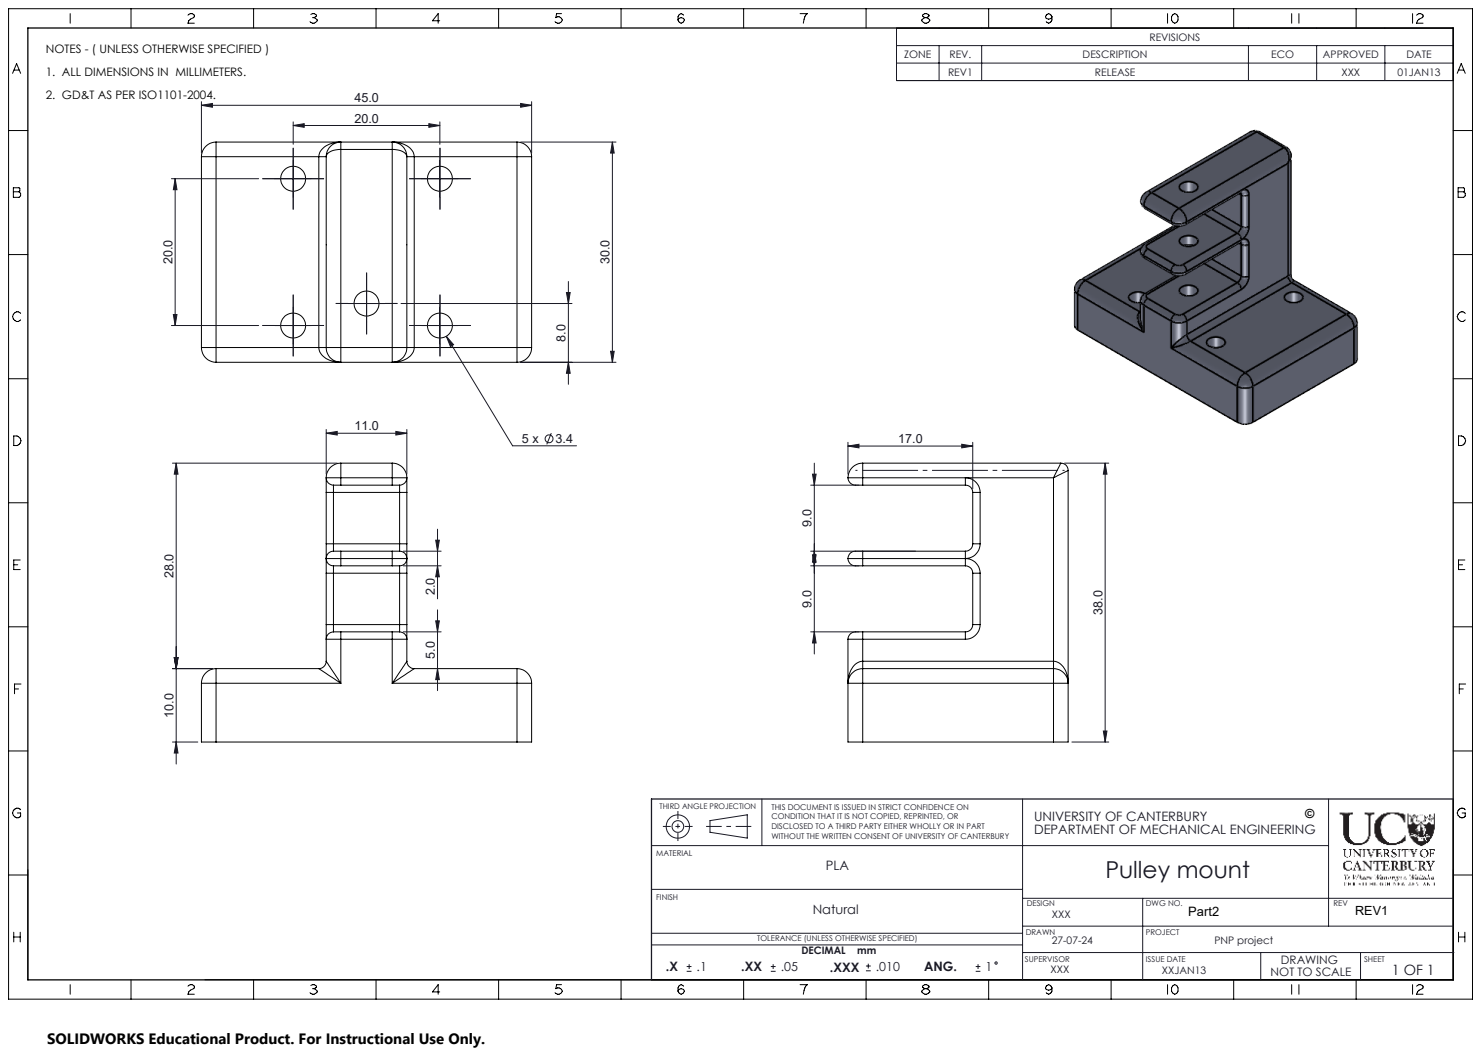
[picture p53: page 1]
.XXX .010

REVISIONS

NOTES - ( UNLESS OTHERWISE SPECIFIED )
1. ALL DIMENSIONS IN MILLIMETERS.
2. GD&T AS PER ISO1101-2004.

ZONE | REV. | DESCRIPTION | ECO | APPROVED | DATE

REV1 | RELEASE | | XXX | 01JAN13

THIRD ANGLE PROJECTION | THIS DOCUMENT IS ISSUED IN STRICT CONFIDENCE ON CONDITION THAT IT IS NOT COPIED, REPRINTED, OR DISCLOSED TO A THIRD PARTY EITHER WHOLLY OR IN PART WITHOUT THE WRITTEN CONSENT OF UNIVERSITY OF CANTERBURY | © UNIVERSITY OF CANTERBURY DEPARTMENT OF MECHANICAL ENGINEERING
MATERIAL PLA | | Pulley mount

DESIGN XXX | DWG NO. Part2 | REV REV1

TOLERANCE (UNLESS OTHERWISE SPECIFIED)
DECIMAL mm

DRAWN 27-07-24 | PROJECT PNP project
SUPERVISOR XXX | ISSUE DATE XXJAN13 | DRAWING NOT TO SCALE | SHEET 1 OF 1

SOLIDWORKS Educational Product. For Instructional Use Only.
