Liam-McCord/PNP-Project-ENMT211/(commit log)

2024-07-16 Liam Gantry Design
2024-07-18 Upload rough drawing of gantry idea. - similar to Liam's but without uprights on each side - probably not use
2024-07-23 Base parts to laser cut
    These are the parts that we need to laser cut for the base of our PNP machine.
    [bottomplatePNP.SLDPRT, gussets.SLDPRT, movingpart.SLDPRT, side_walls.SLDPRT]
2024-07-23 Mount Block STL Draft
    The draft for the 3d-printed mount block.
    [mountblock.STL]
2024-07-24 design mounting bracket for xy rails
    [Part1.SLDPRT, Part2.SLDPRT]
2024-07-25 dimension parts for printing, create assembly of both parts for compatibility checking
    [Part1.SLDPRT, Part2.SLDPRT, xybracket.SLDASM]
2024-07-25 update dimension for pulley pin hole
    [Part2.SLDPRT]
2024-07-25 update dimensions
    [Part1.SLDPRT, xybracket.SLDASM]
2024-07-25 Updated SLDPRT and DXF parts
    These should be working updated parts.
    [bottomplatePNP.DXF, bottomplatePNP.SLDPRT, gussets.DXF, gussets.SLDPRT, side_walls.DXF, side_walls.SLDPRT]
2024-07-27 update dimensions/shape/fillets of bracket
    [Part1.SLDDRW, Part1.SLDPRT, Part2.SLDDRW, Part2.SLDPRT, xybracket.SLDASM]
2024-07-28 update dimesions, add second bracket
    [Part1.SLDDRW, Part2.SLDDRW, Part2.SLDPRT, Part3.SLDPRT]
2024-07-28 Add updated motor mount sldprt file
    Added updated motor mount sldprt file to account for slightly taller motor than expected.
    [Motor Mount.SLDPRT]
2024-07-29 create STL files for printing
    [Motor Mount.STL, Part1.STL, Part2.STL]
2024-07-29 suction head mount block
    [mountblock.SLDPRT]
2024-07-29 tidy file managment and naming
    [Motor Mount.SLDPRT, Motor Mount.STL, Part1.SLDDRW, Part1.SLDPRT, Part1.STL, Part2.SLDDRW, Part2.SLDPRT, Part2.STL]
2024-07-29 reflected and modified second pulley mount opposite motor
    [pulley mount PRINT-THE-MIRRORD-ENTITY.SLDPRT, pulley mount sideONE.SLDPRT, pulley mount sideTWO.SLDPRT]
2024-07-30 Delete Mounts&Brackets for Printing/motor mount/Motor Mount.SLDPRT
    Delete for upload of updated file
    [Motor Mount.SLDPRT]
2024-07-30 Delete Mounts&Brackets for Printing/motor mount/Motor Mount.STL
    Delete for upload of updated part
    [Motor Mount.STL]
2024-07-30 Create To print
    Attempt at creating To Print folder
2024-07-30 Add files via upload
    Add motor mount and moving platform mounts to be 3D printed
    [Motor Mount.SLDPRT, Motor Mount.STL, Moving Platform Mount.SLDPRT, Moving Platform Mount.STL]
2024-08-01 add clearance pulley and modified RHS motor mount
    [Motor Mount with extra bracket for clearance.SLDPRT, cleareance pulley left.SLDPRT]
2024-08-01 add folder for parts to be printed
    [Motor Mount with extra bracket for clearance.SLDPRT, cleareance pulley left.SLDPRT]
2024-08-01 tidy files
    [Motor Mount with extra bracket for clearance.SLDPRT, cleareance pulley left.SLDPRT]
2024-08-04 RHS pulley mount.
    Print this as it should work for the belt configuration.
    [pulley mount right hand side mirror.SLDPRT]
2024-08-05 modify bracket
    [pulley mount PRINT-THE-MIRRORD-ENTITY.SLDPRT, pulley mount side left.SLDPRT, pulley mount sideONE.SLDPRT]
2024-08-05 Fixed coincident error
    just fixed a coincident error that may have caused issues in the model :)
    [pulley mount side left.SLDPRT]
2024-08-05 Changed motor mount bracket length and filleted the side
    [Motor Mount with extra bracket for clearance.SLDPRT]
2024-08-05 fix motor mount hole spacing
    [Motor Mount with extra bracket for clearance.SLDPRT]
2024-08-05 add parts to be printed
    [Motor Mount with extra bracket for clearance.SLDPRT, pulley mount PRINT-THE-MIRRORD-ENTITY.SLDPRT, pulley mount side left.SLDPRT]
2024-08-05 Hole sizes updated, distanced to 31mm
    [Motor Mount with extra bracket for clearance.SLDPRT]
2024-08-05 Add files via upload
    corrected the distance between motor holes
    [Motor Mount.STL]
2024-08-05 Delete Mounts&Brackets for Printing/Motor Mount.SLDPRT
    wrong dimensions
    [Motor Mount.SLDPRT]
2024-08-05 Delete Mounts&Brackets for Printing/Motor Mount.STL
    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
    [Motor Mount.STL]
2024-08-05 Add partial assembly. All parts have been copied into assembly folder and will not auto-update.
    [01 - Board Assembly.SLDASM, 02 - Board with 2 Beams Assembly.SLDASM, 03 - Board, Beams, and Sliders.SLDASM, 04 - Assembly with Motors.SLDASM, 2040 Aluminim profile.SLDPRT, BType_TNut_6_M5.STEP.SLDPRT, Bottom Plate.SLDPRT, DC Stepper Motor.SLDPRT]
2024-08-06 Baseplate connector for the Z-Screw
    Made an initial design for the connector that holds the z-screw baseplate in place.
    [baseplate-bracket.SLDPRT]
2024-08-06 add packer
    [Part1.SLDPRT]
2024-08-06 create stl file
    [Part1.STL, part1-final.SLDPRT, part1-final.STL]
2024-08-06 STL file for baseplate bracket
    For printing :)
    [baseplate-bracket.STL]
2024-08-06 Baseplate files to lasercut :)
    Baseplate files to lasercut for the baseplate on the z screw
    [baseplate-plate-to-lasercut.DXF, baseplate-plate-to-lasercut.SLDPRT]
2024-08-16 add some images for report, add report backup txt file
    [Part2.SLDPRT, comparison of pulley printingSLDASM.SLDASM, part1-final.SLDPRT, pulley mount right hand side mirror.SLDPRT]
